AerospaceVillage/avBadge_2022/B2/images/usaf-b2-spirit-overhead-view.jpg

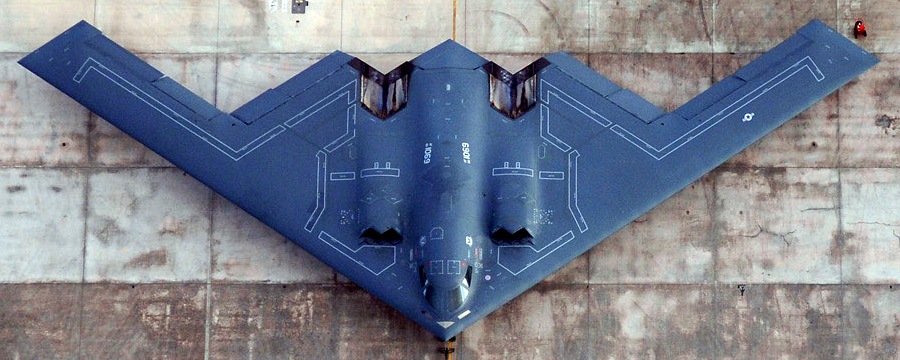
B2/images/usaf-b2-spirit-overhead-view.jpg
