AerospaceVillage/avBadge_2022/Images/DC30 theme.webp

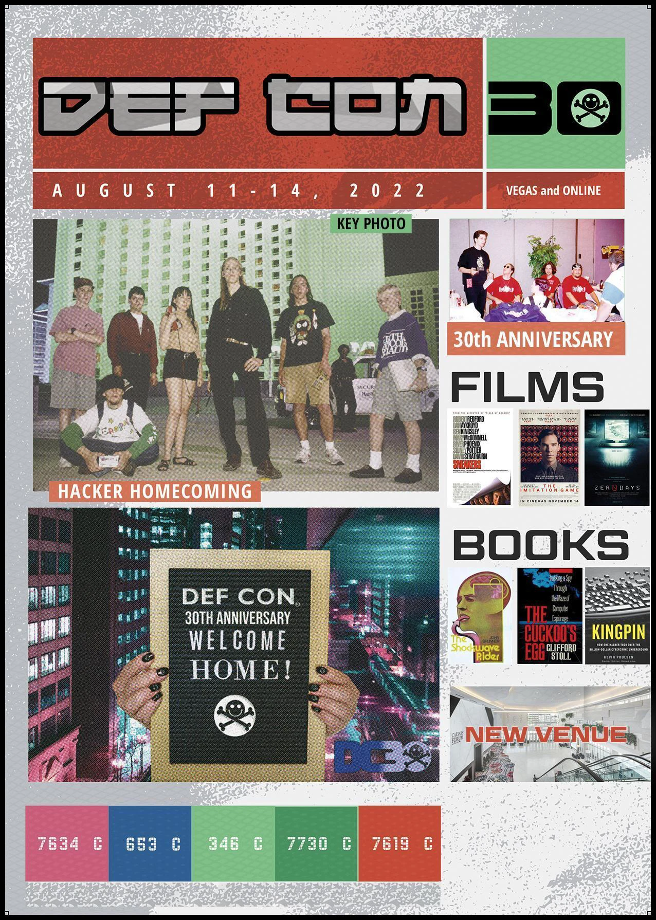
Images/DC30 theme.webp
