AerospaceVillage/avBadge_2022/README.md

# Aerospace Village Badge(s) for Defcon 2022

A collection of v1.69 SAO badges to be presented at DefCon 2022

4/25/2022
Began working in earnest on the primary base badge

5/11/2022
Surged today to get the Space and Earth portions into the JLCPCB manufacturer with SMT services for some of the components.
