AerospaceVillage/avBadge_2022/an225/images/An-124_and_An-225_top-view_silhouettes.png

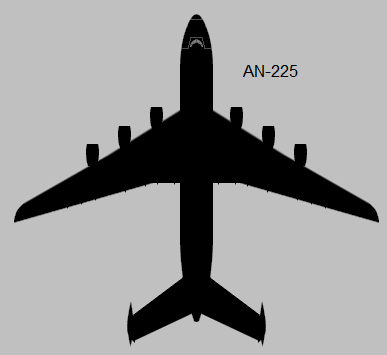
an225/images/An-124_and_An-225_top-view_silhouettes.png
