AerospaceVillage/avBadge_2022/B2/images/31hubGdG-TL._AC_.jpg

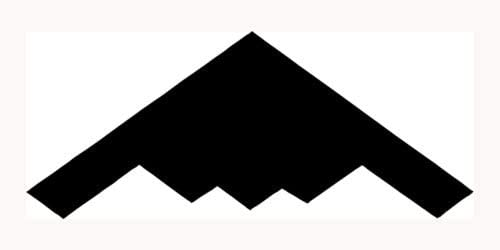
B2/images/31hubGdG-TL._AC_.jpg
