AerospaceVillage/avBadge_2022/B2/images/261D0600-A7CA-4D3E-8E26-1C9C6CC0517F.webp

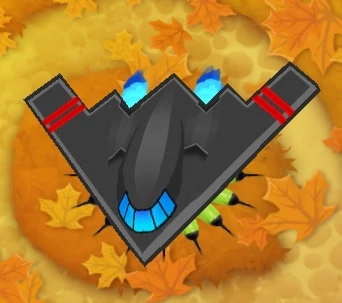
B2/images/261D0600-A7CA-4D3E-8E26-1C9C6CC0517F.webp
