AerospaceVillage/avBadge_2022/B2/images/1024px-B2_Spirit_closeup.JPEG

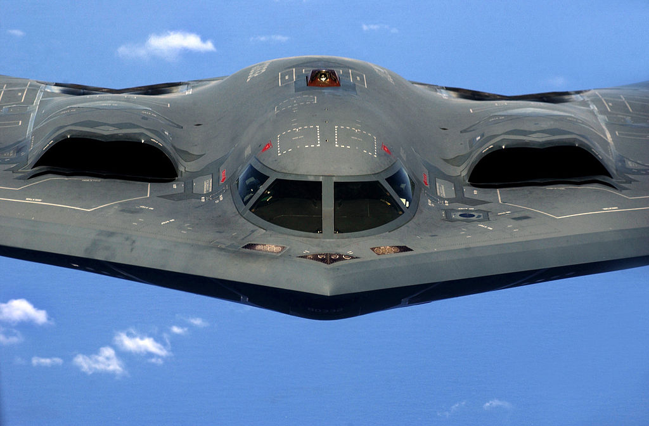
B2/images/1024px-B2_Spirit_closeup.JPEG
