AerospaceVillage/avBadge_2022/B2/images/b2-stealth-bomber-jet-aircraft-twilight-organic-synthesis.jpg

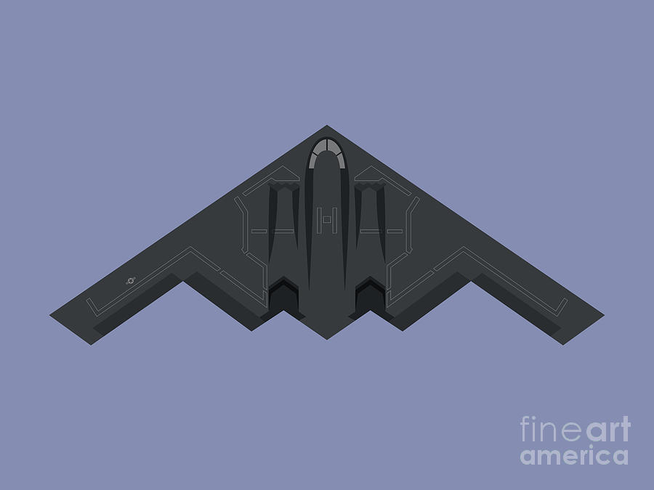
B2/images/b2-stealth-bomber-jet-aircraft-twilight-organic-synthesis.jpg
