AerospaceVillage/avBadge_2022/B2/images/b-2-tops-art.jpg

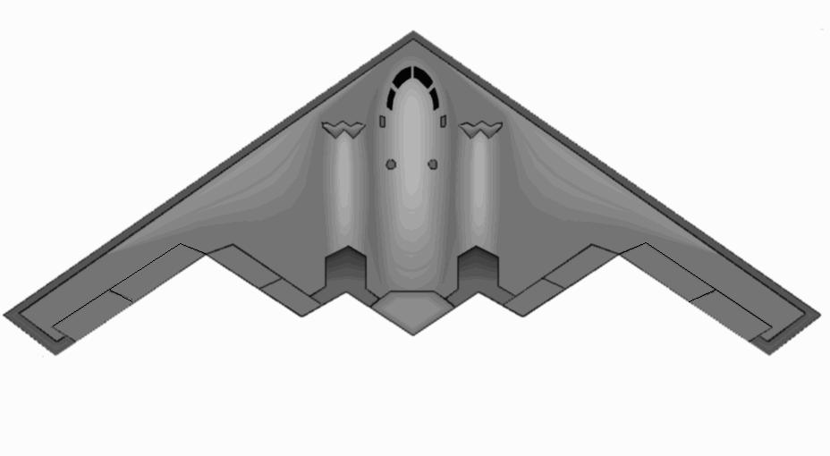
B2/images/b-2-tops-art.jpg
