AerospaceVillage/avBadge_2022/B2/images/b-2_line.gif

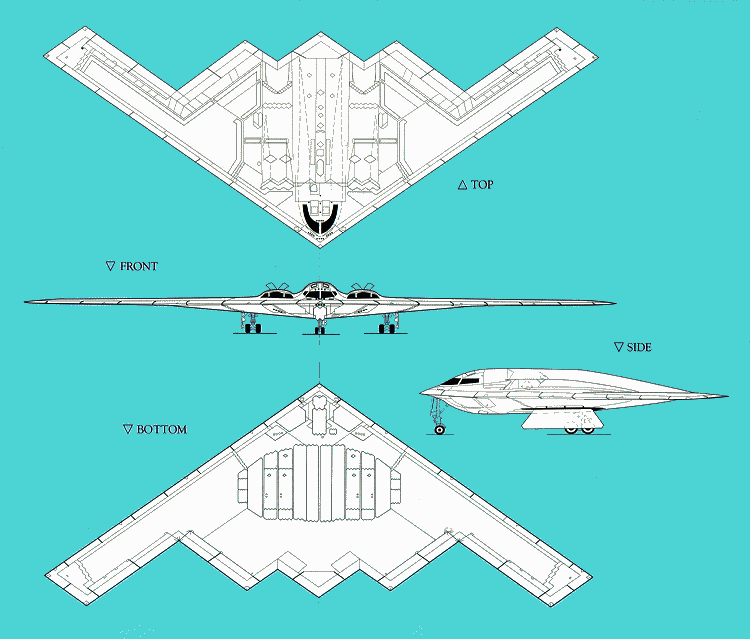
B2/images/b-2_line.gif
