AerospaceVillage/avBadge_2022/B2/images/B-2A_Silo500_ZE-300x300.png

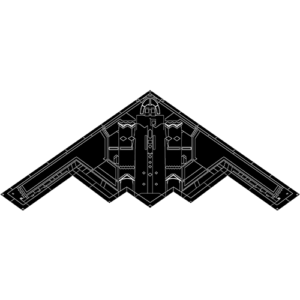
B2/images/B-2A_Silo500_ZE-300x300.png
