AerospaceVillage/avBadge_2022/B2/images/CleanShot 2022-07-21 at 14.04.40@2x.jpg

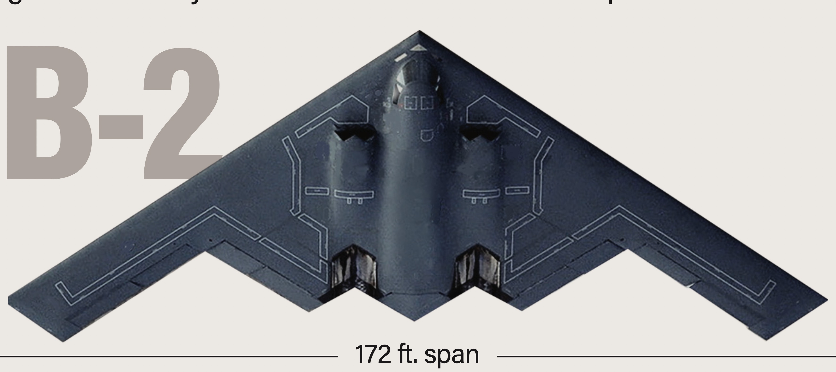
B2/images/CleanShot 2022-07-21 at 14.04.40@2x.jpg
