AerospaceVillage/avBadge_2022/Caution_SAO/Caution_SAO.png

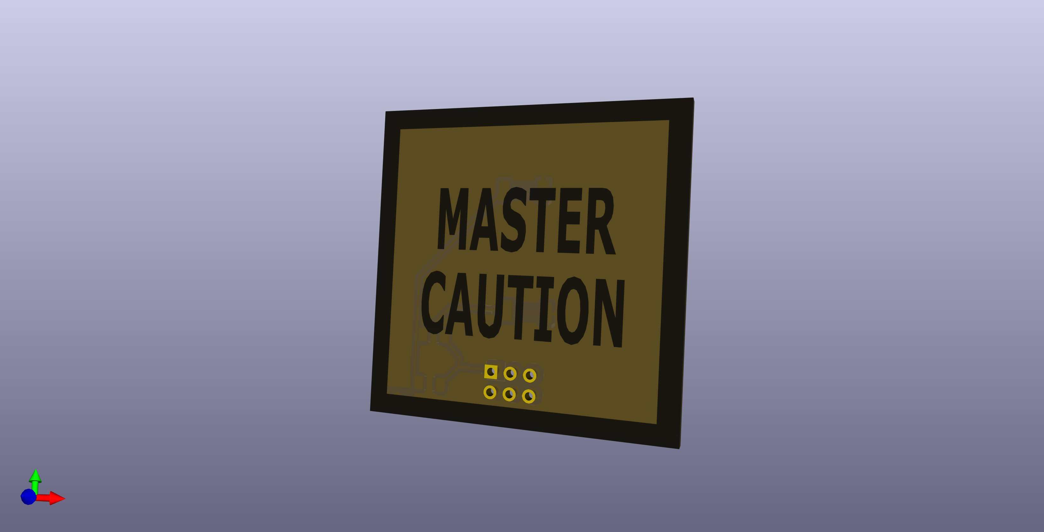
Caution_SAO/Caution_SAO.png
