AerospaceVillage/avBadge_2022/gold_star_v2_SAO/aerospace village - negative with filled background.png

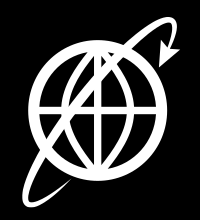
gold_star_v2_SAO/aerospace village - negative with filled background.png
