AerospaceVillage/avBadge_2022/gold_star_v2_SAO/aerospace village - no words.png

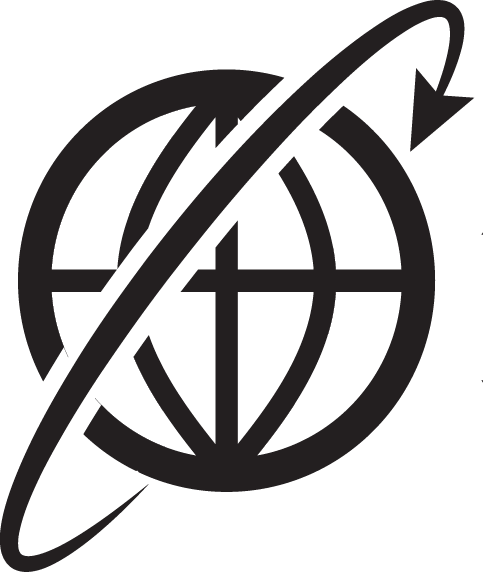
gold_star_v2_SAO/aerospace village - no words.png
