AerospaceVillage/avBadge_2022/james_webb_telescope_SAO/images/substrate mirror.png

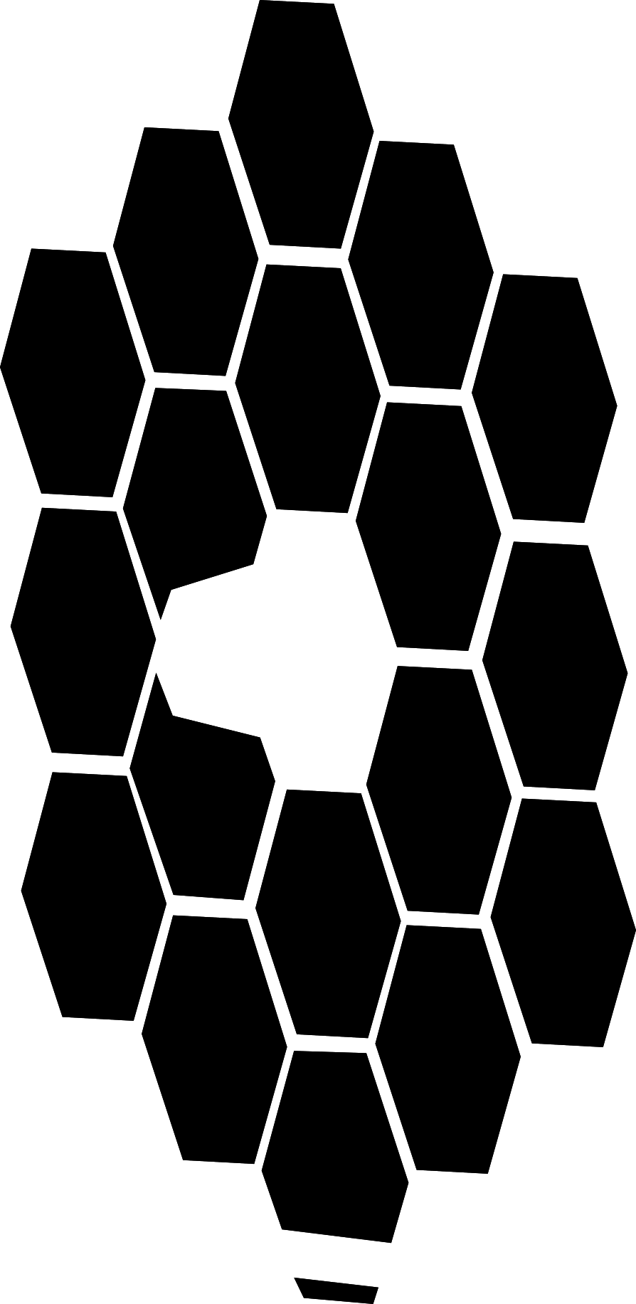
james_webb_telescope_SAO/images/substrate mirror.png
