AerospaceVillage/avBadge_2022/space_shuttle_SAO/space_shuttle_SAO.png

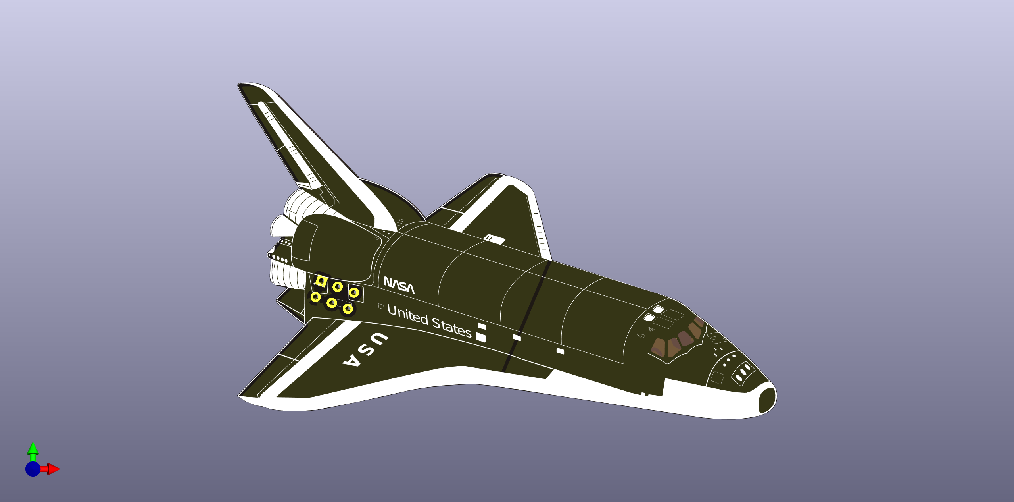
space_shuttle_SAO/space_shuttle_SAO.png
