AerospaceVillage/avBadge_2022/sr-71_SAO/sr-71.png

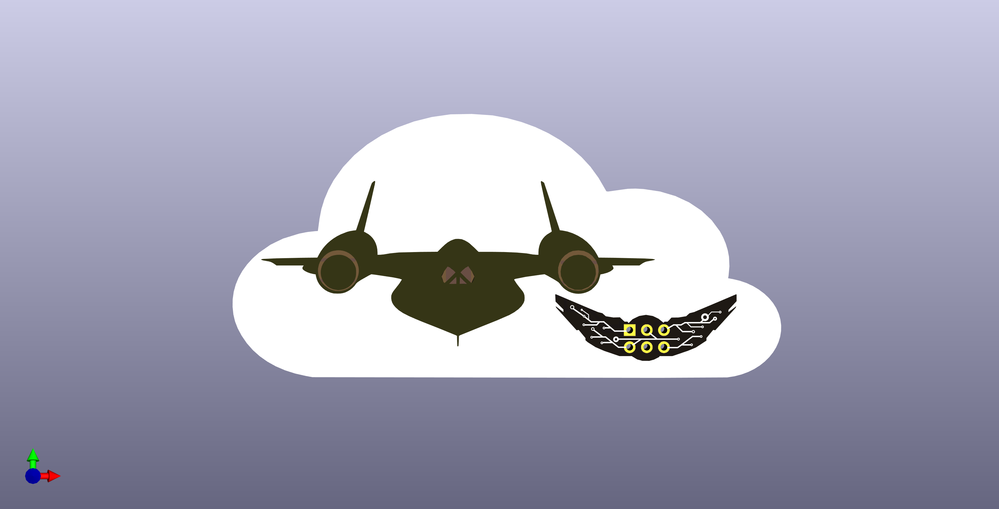
sr-71_SAO/sr-71.png
