AerospaceVillage/avBadge_2022/BaseBadge/earth_base/earth_base_BOM.csv

Comment | Designator | Footprint | LCSC Part Number
330 | R1, R2, R3, R4 | Capacitor_SMD:C_0805_2012Metric | C17630
LED | D1, D2, D3, D4 | 0603 | C72038
