AerospaceVillage/avBadge_2022/Images/sr71_symetricView.dxf

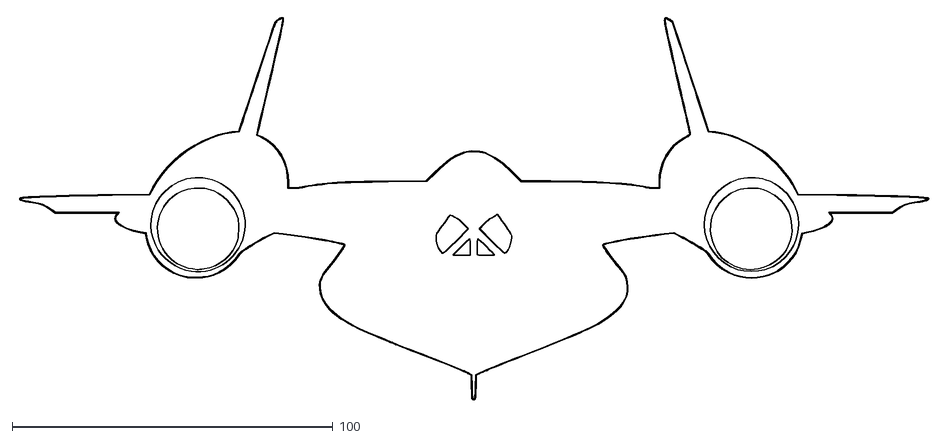
[picture p20: CAD file, 2022-04-05]
Images/sr71_symetricView.dxf
284.3 x 119.5
