AerospaceVillage/avBadge_2022/soldering jigs/sao_jig.stl

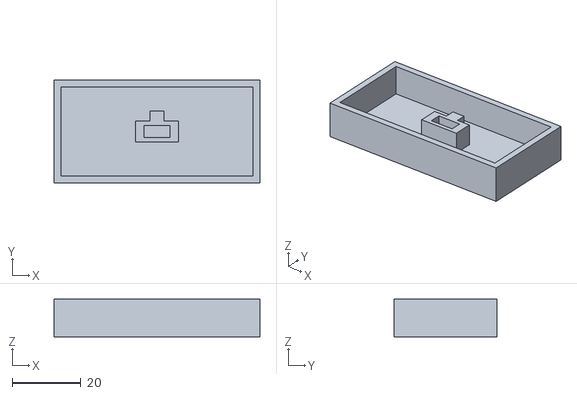
[picture p21: CAD file, 2022-07-29]
soldering jigs/sao_jig.stl
60.0 x 30.0 x 11.0
