AerospaceVillage/avBadge_2022/Images/aerospace_logo_new.dxf

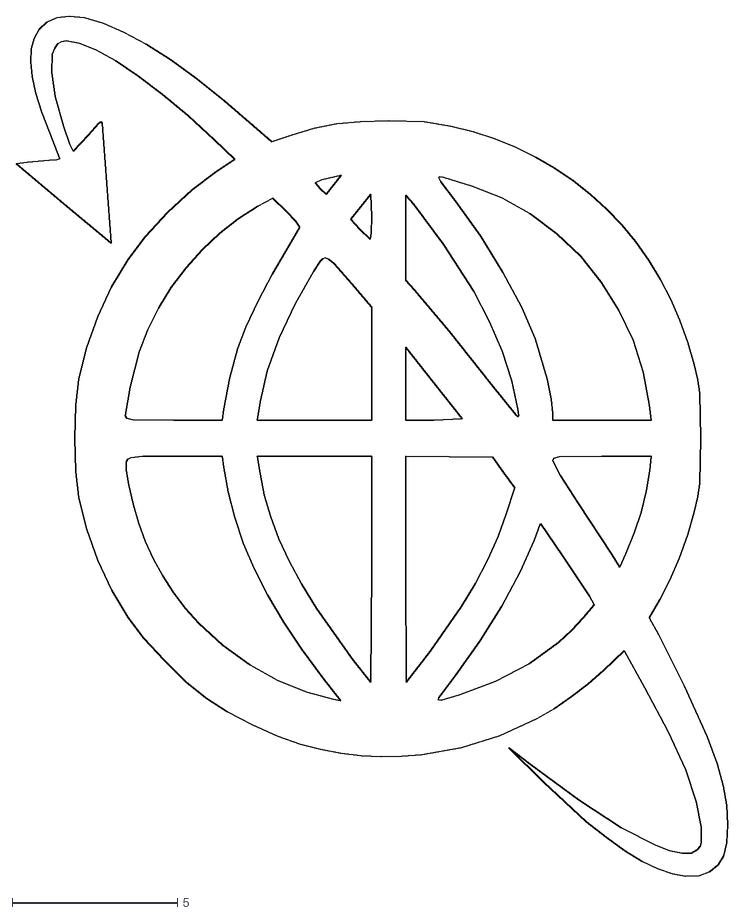
[picture p22: CAD file, 2022-04-05]
Images/aerospace_logo_new.dxf
21.5 x 26.0
