AerospaceVillage/avBadge_2022/soldering jigs/sao_jig-x15.3mf

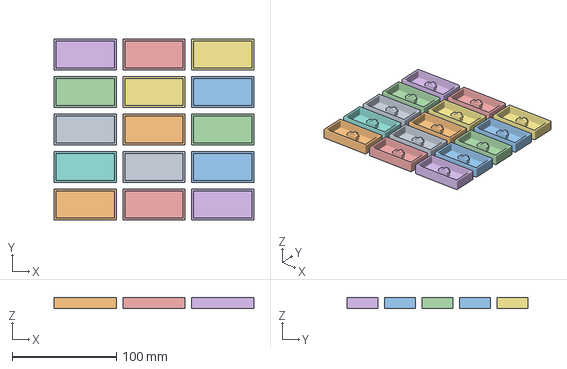
[picture p23: CAD file, 2022-07-29]
soldering jigs/sao_jig-x15.3mf
192.0 x 174.0 x 11.0 mm
