AerospaceVillage/avBadge_2022/Images/sr71_symetricView_outline.dxf

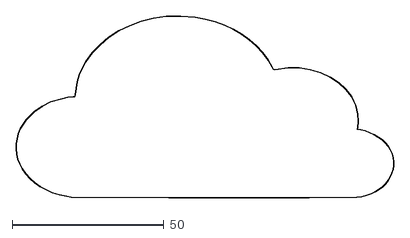
[picture p24: CAD file, 2022-04-05]
Images/sr71_symetricView_outline.dxf
124.3 x 59.8
