AerospaceVillage/avBadge_2022/(list of files, cad)

Other CAD files:
soldering jigs/sao_jig-single.3mf
