AerospaceVillage/avBadge_2022/space_shuttle_SAO/assembly instructions/shuttle_SAO_assembly.pdf

# Aerospace Village Badge 2022 Shuttle SAO Assembly

Components:
- SAO Male Connector
- x1 330 Ohm reistors
- x1 Yellow LEDs

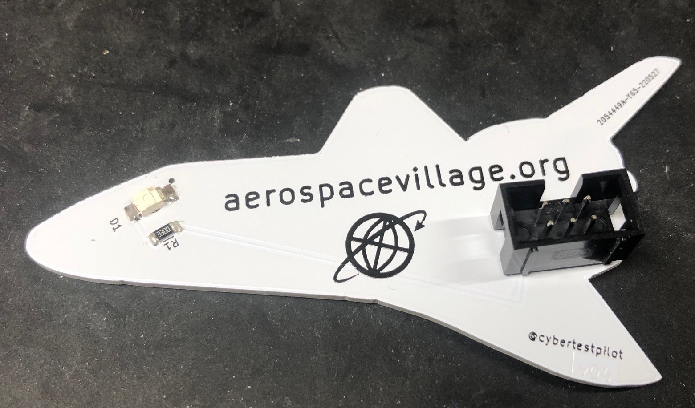
[picture p25: figure]

1. Solder the resistor to the respective pads. Note: Orientation does not matter for the resistor.
2. Orient the yellow LED so that the circles on the PCB and LED are adjacent to one another and then solder the LEDs in place.

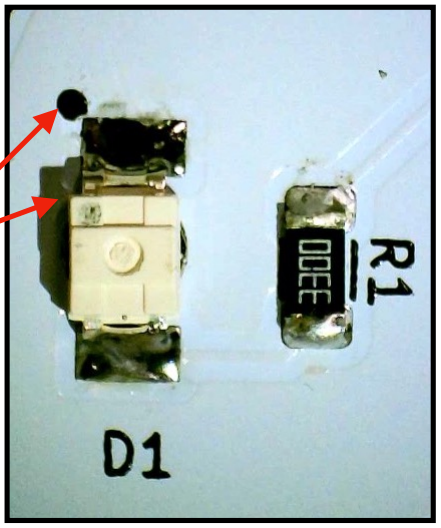
[picture p26: figure]
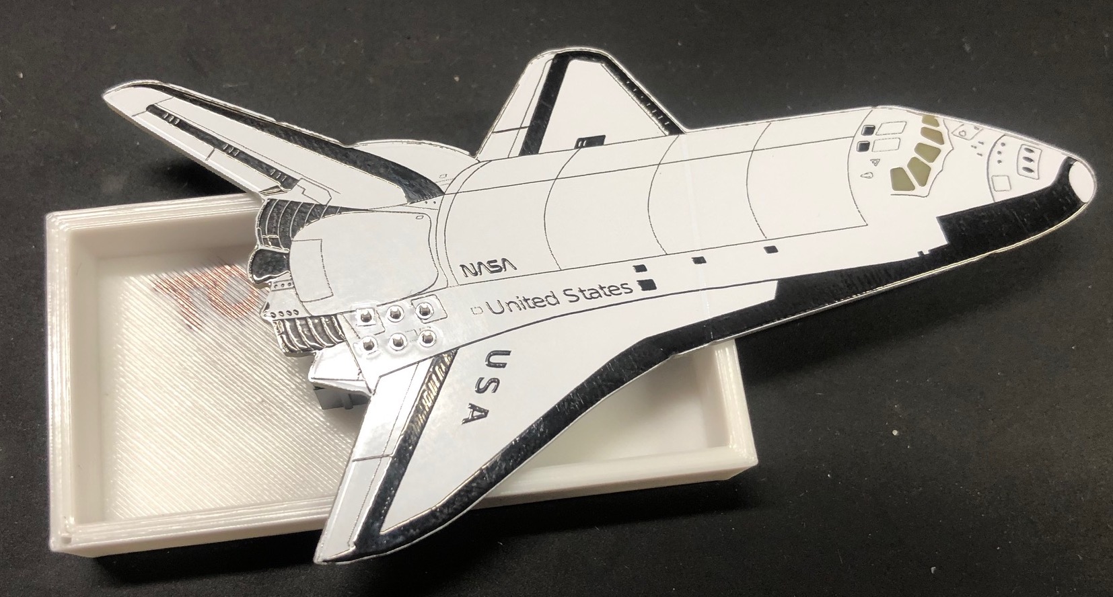
[picture p27: figure]

3. Using the SAO jig solder the connector to the back of the PCB.
4. Ensure correct operation.

Observe the
orientation markings

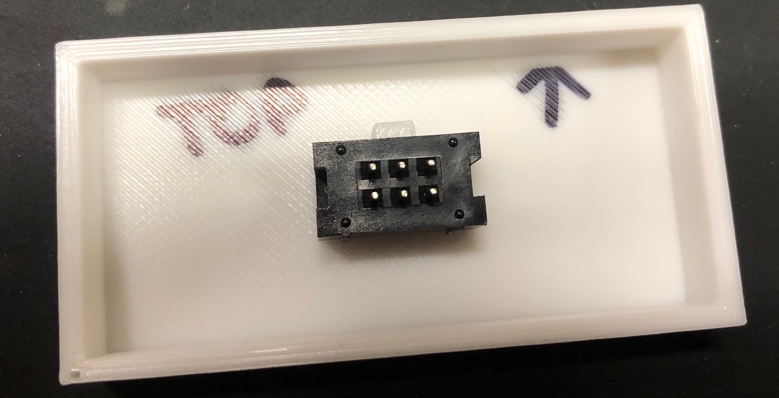
[picture p28: figure]
