AerospaceVillage/avBadge_2022/Warning_SAO/assembly instructions/warning_SAO_assembly.pdf

# Aerospace Village Badge 2022 Warning SAO Assembly

Components:
- SAO Male Connector
- x2 1K Ohm reistors
- x2 Red LEDs

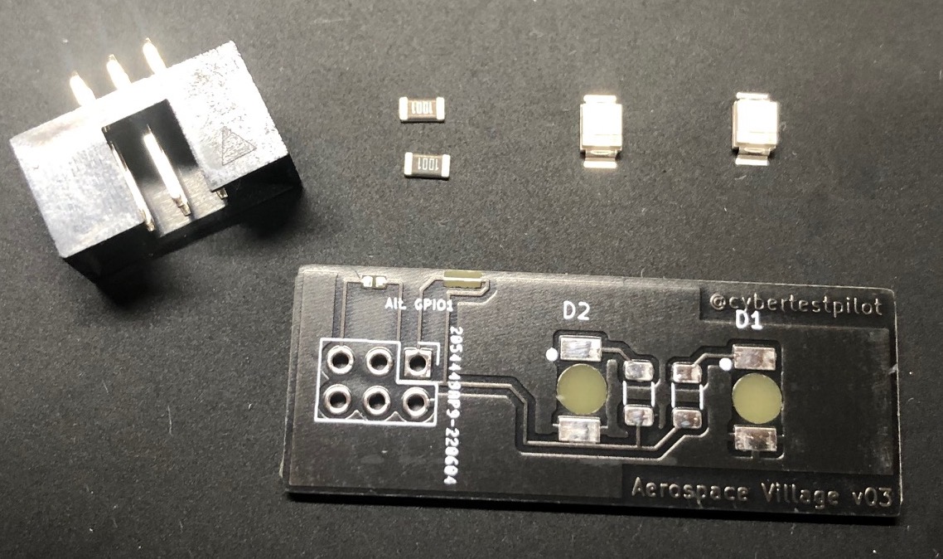
[picture p29: figure]

1. Solder the resistors to their respective pads. Note: Orientation does not matter for the resistors
2. Orient the red LEDs so that the circles on the PCB and LED are adjacent to one another and then solder the LEDs in place.

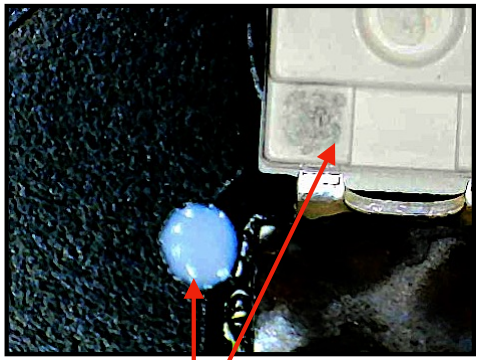
[picture p30: figure]
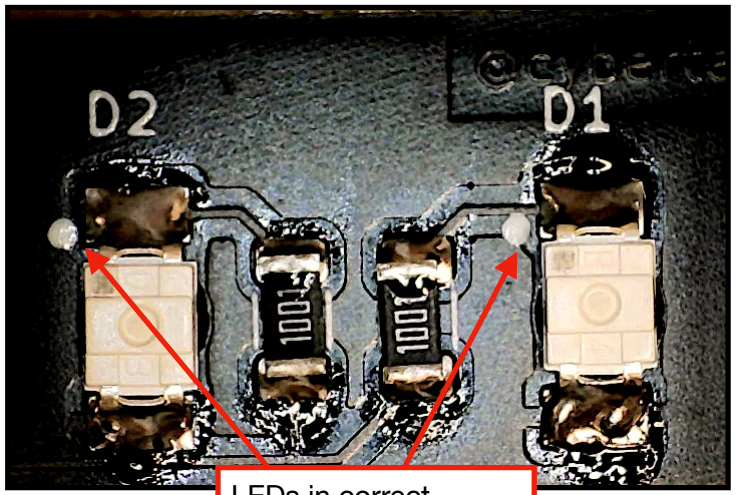
[picture p31: figure]

3. Using the SAO jig solder the connector to the back of the PCB.


4. Ensure correct operation.

LEDs in correct
orientation

Observe the
orientation markings

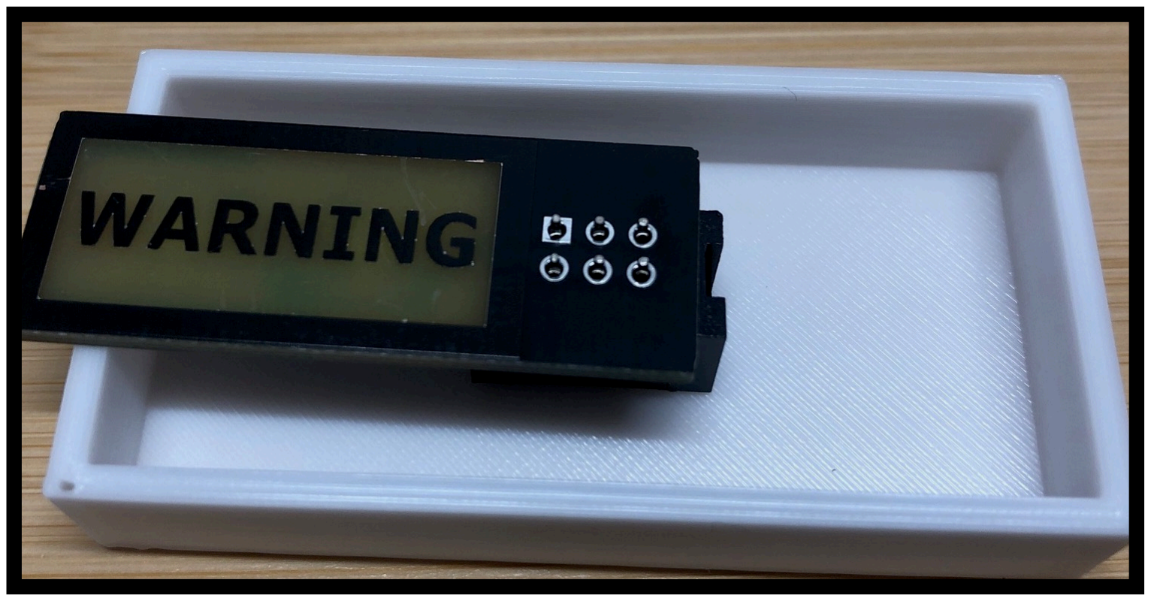
[picture p32: figure]
