AerospaceVillage/avBadge_2022/787 SAO multiplier/787.kicad_pcb

## KiCad design 787 SAO multiplier/787.kicad_pcb (2022-07-29)

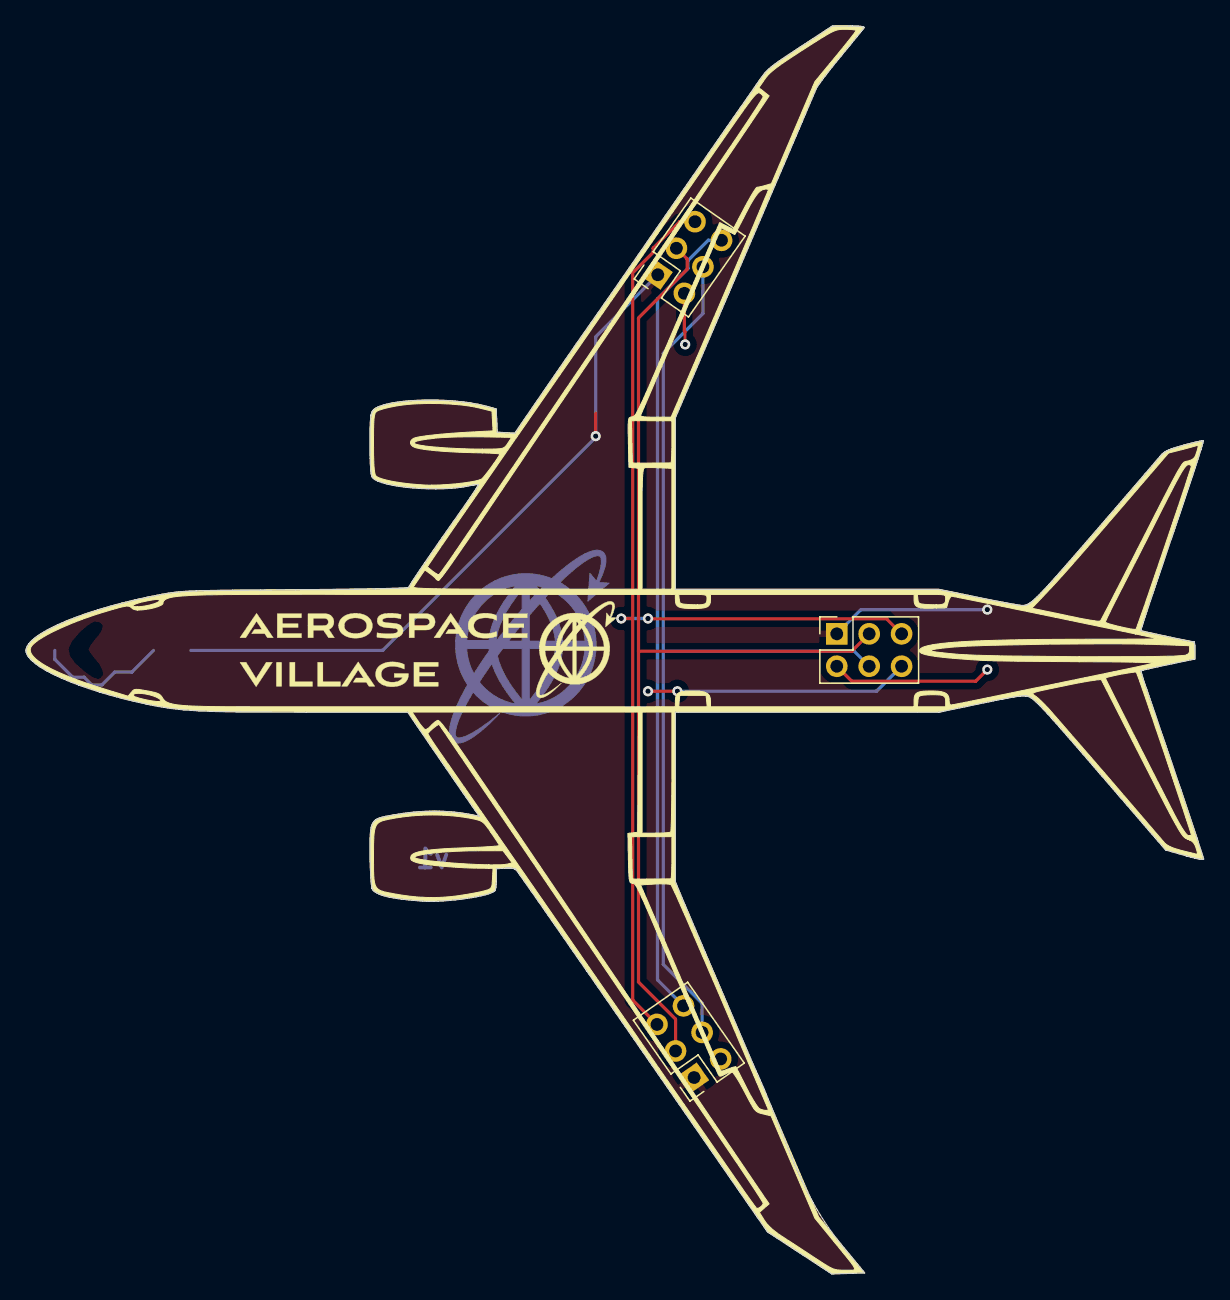
[picture p35: board 787.kicad_pcb from above]

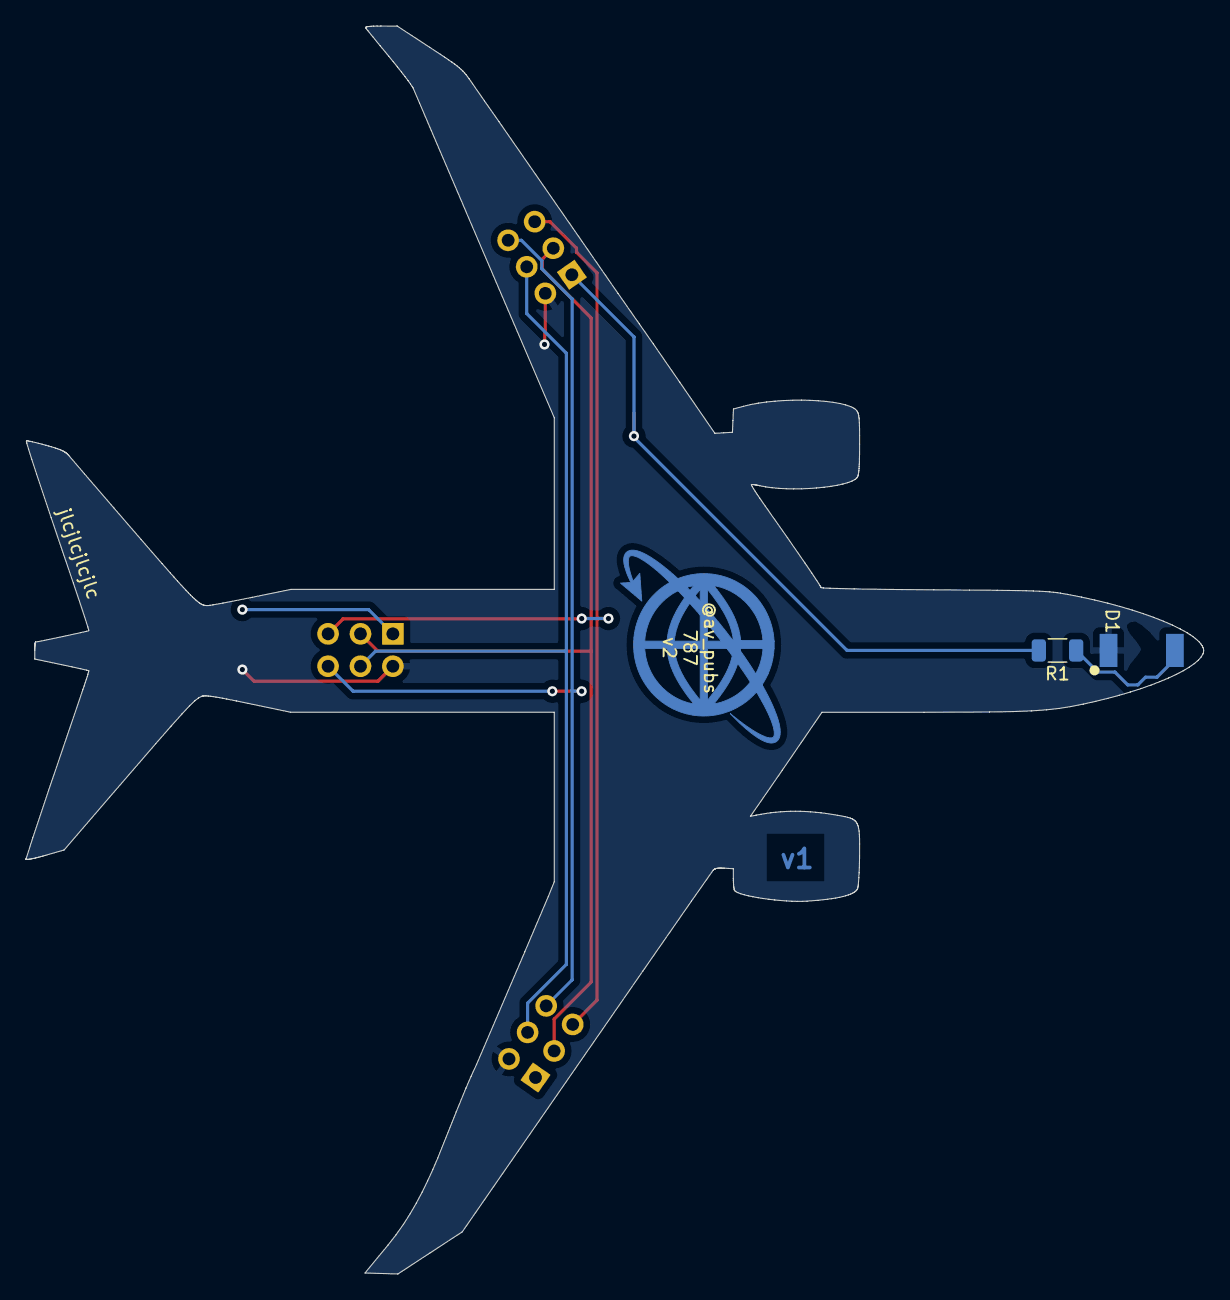
[picture p36: board 787.kicad_pcb from below]

Board: 2 copper layers, 92.3 x 97.8 mm, 5 parts (2 on the bottom side), 7 nets.

Parts:
D1: LED; XZMYK45WT-9
J1, J2, J3: Conn_02x03_Counter_Clockwise; PinSocket_2x03_P2.54mm_Vertical
R1: R; R_1206_3216Metric

Connections:
+3V3: J1.1, J2.1, J3.1, R1.2
GND: D1.1 (K), J1.2, J2.2, J3.2
unnamed: D1.2 (A), R1.1
unnamed: J1.3, J2.3, J3.3
unnamed: J1.4, J2.4, J3.4
unnamed: J1.5, J2.5, J3.5
unnamed: J1.6, J2.6, J3.6
