AerospaceVillage/avBadge_2022/VORTAC_SAO/VORTAC SAO Board.kicad_pcb

## KiCad design VORTAC_SAO/VORTAC SAO Board.kicad_pcb (2022-07-29)

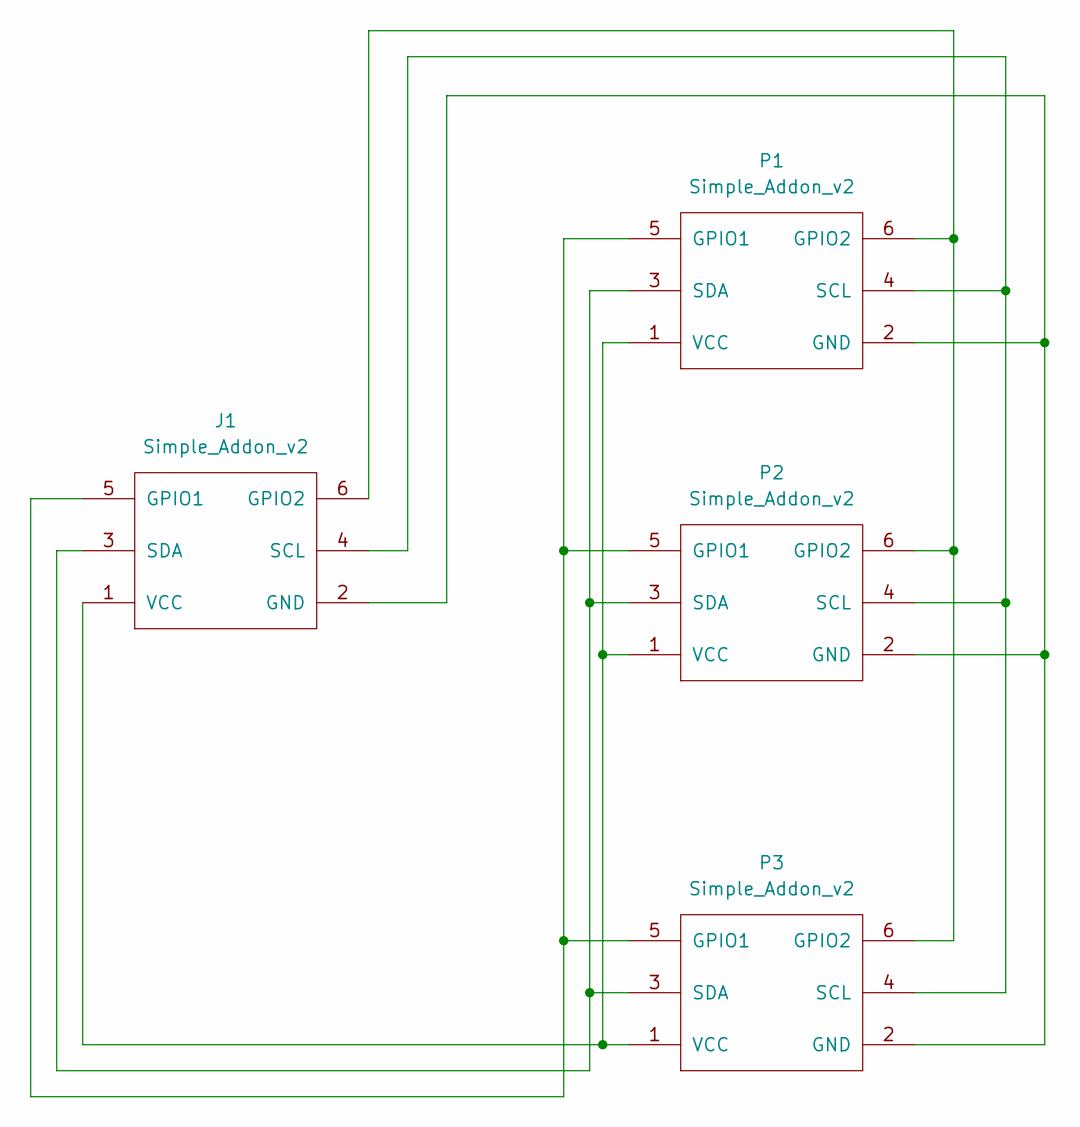
[picture p37: schematic VORTAC SAO Board.kicad_sch]

Parts:
J1: Simple_Addon_v2; Simple_Addon_v2-SAO-2x3
P1, P2, P3: Simple_Addon_v2; Simple_Addon_v2-BADGE-2x3

Connections:
unnamed: J1.1 (VCC), P1.1 (VCC), P2.1 (VCC), P3.1 (VCC)
unnamed: J1.2 (GND), P1.2 (GND), P2.2 (GND), P3.2 (GND)
unnamed: J1.3 (SDA), P1.3 (SDA), P2.3 (SDA), P3.3 (SDA)
unnamed: J1.4 (SCL), P1.4 (SCL), P2.4 (SCL), P3.4 (SCL)
unnamed: J1.5 (GPIO1), P1.5 (GPIO1), P2.5 (GPIO1), P3.5 (GPIO1)
unnamed: J1.6 (GPIO2), P1.6 (GPIO2), P2.6 (GPIO2), P3.6 (GPIO2)

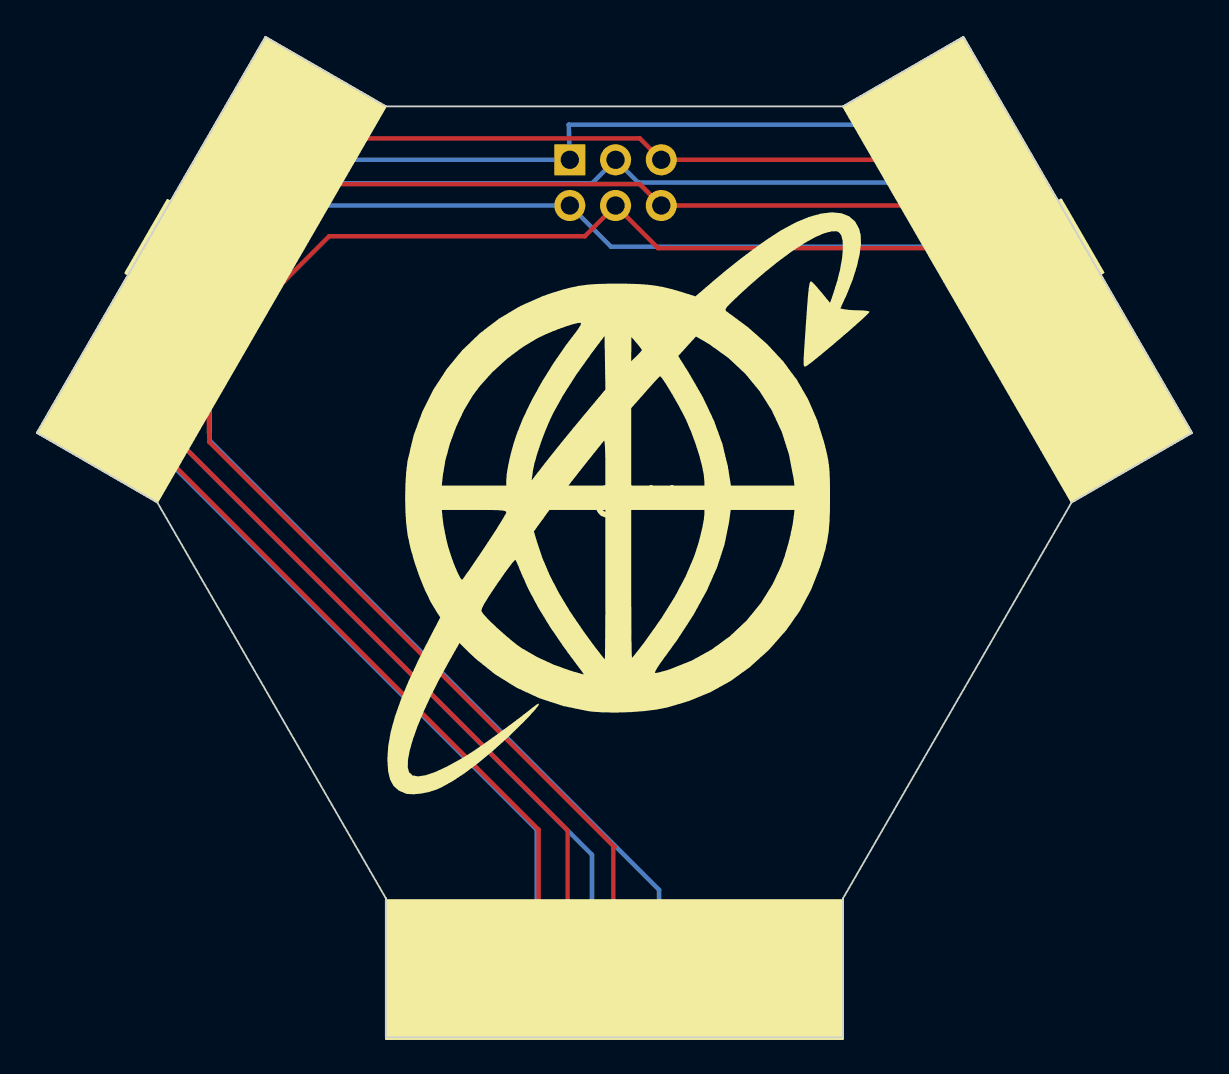
[picture p38: board VORTAC SAO Board.kicad_pcb from above]

Board: 2 copper layers, 64.2 x 55.6 mm, 4 parts (0 on the bottom side), 6 nets.
