AerospaceVillage/avBadge_2022/BaseBadge/space_base/BaseBadge.kicad_pcb

## KiCad design BaseBadge/space_base/BaseBadge.kicad_pcb (2022-06-02)

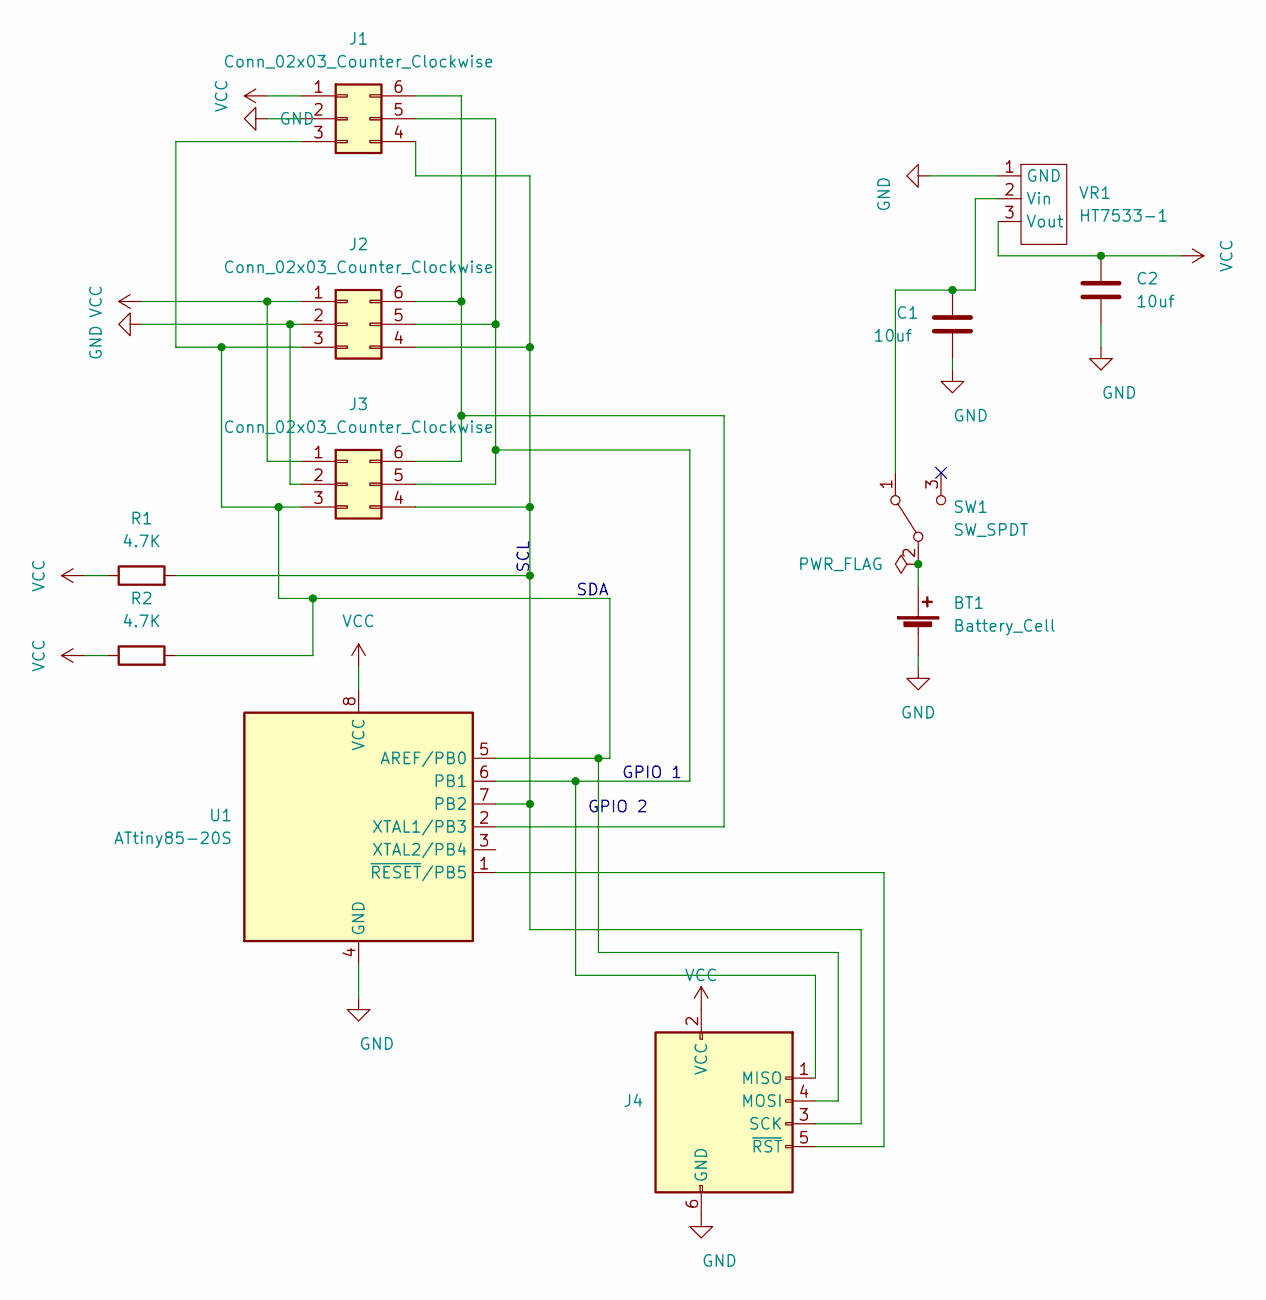
[picture p40: schematic BaseBadge.kicad_sch]

Parts:
BT1: Battery_Cell; 2479
C1, C2: 10uf; C_0805_2012Metric
J1: Conn_02x03_Counter_Clockwise; space2sky_connector
J2, J3: Conn_02x03_Counter_Clockwise; PinSocket_2x03_P2.54mm_Vertical
J4: (no value)
R1, R2: 4.7K; R_0805_2012Metric
SW1: SW_SPDT; switch_JS202011SCQN
U1: ATtiny85-20S; SOIC-8W_5.3x5.3mm_P1.27mm
VR1: HT7533-1; SOT-89-3

Connections:
GND: BT1.2 (-), C1.2, C2.2, J1.2, J2.2, J3.2, J4.6 (GND), U1.4 (GND), VR1.1 (GND)
unnamed: BT1.1 (+), SW1.2 (B)
unnamed: C1.1, SW1.1 (A), VR1.2 (Vin)
unnamed: J1.3, J2.3, J3.3, J4.4 (MOSI), R2.2, U1.5 (AREF/PB0)
unnamed: J1.4, J2.4, J3.4, J4.3 (SCK), R1.2, U1.7 (PB2)
unnamed: J1.5, J2.5, J3.5, J4.1 (MISO), U1.6 (PB1)
unnamed: J1.6, J2.6, J3.6, U1.2 (XTAL1/PB3)
unnamed: J4.5 (~RST), U1.1 (~RESET/PB5)
VCC: C2.1, J1.1, J2.1, J3.1, J4.2 (VCC), R1.1, R2.1, U1.8 (VCC), VR1.3 (Vout)

Notes on the sheet:
GPIO 2
SDA
SCL
GPIO 1

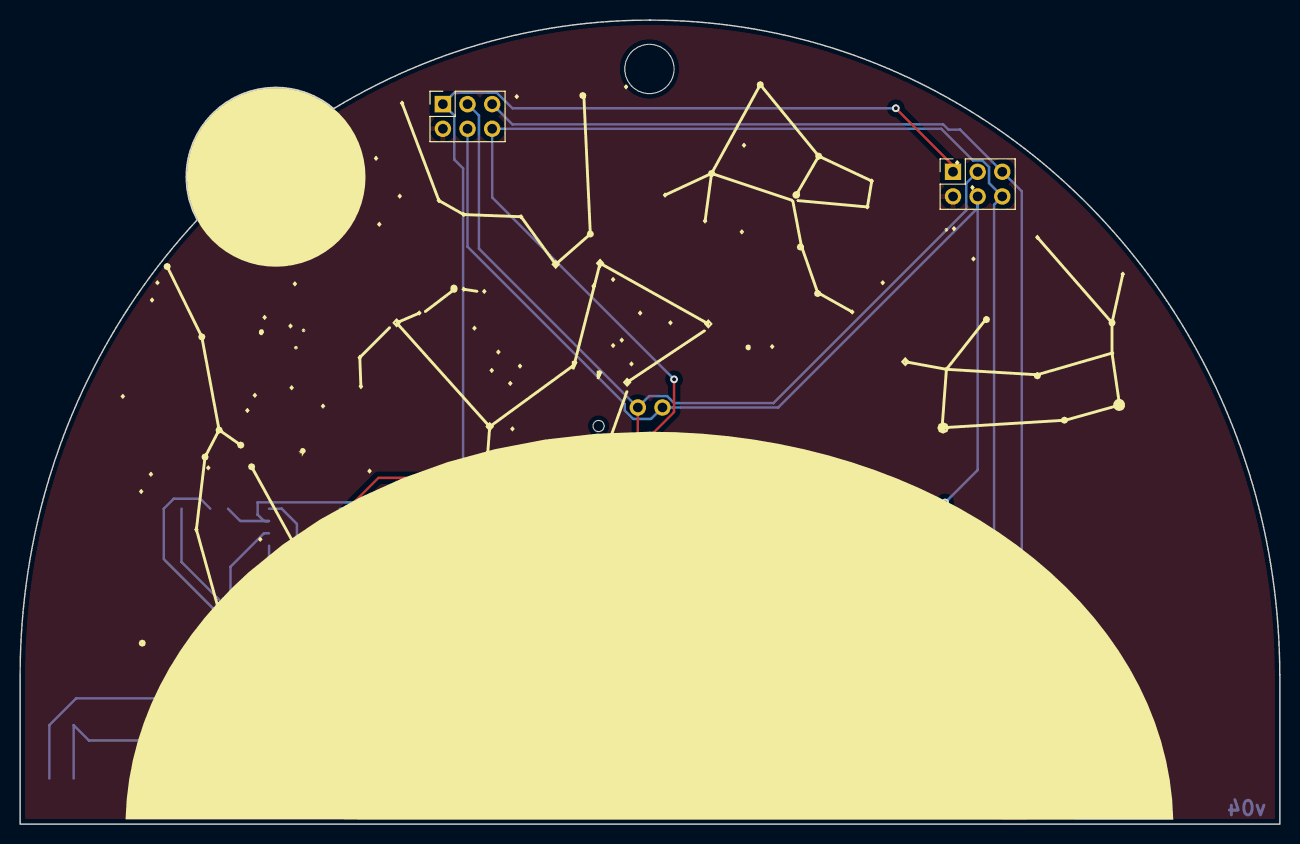
[picture p41: board BaseBadge.kicad_pcb from above]

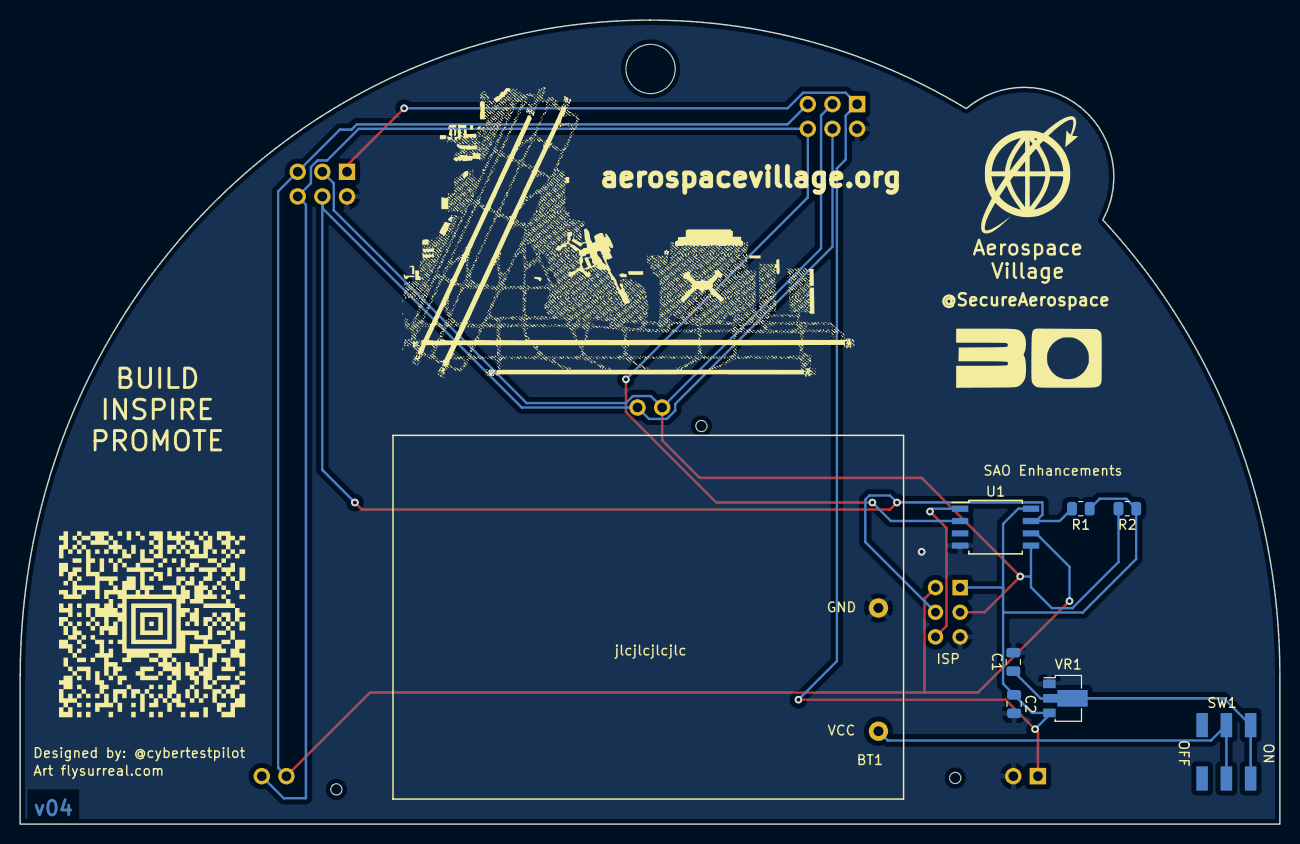
[picture p42: board BaseBadge.kicad_pcb from below]

Board: 2 copper layers, 129.9 x 82.9 mm, 15 parts (11 on the bottom side), 9 nets.

Other parts of the board:
svg2mod: G***; space_base
svg2mod#2: G***; defcon_30_logo
svg2mod#3: G***; aerospace_logo_new
