AerospaceVillage/avBadge_2022/space_shuttle_SAO/space_shuttle_SAO.kicad_pcb

## KiCad design space_shuttle_SAO/space_shuttle_SAO.kicad_pcb (2022-05-26)

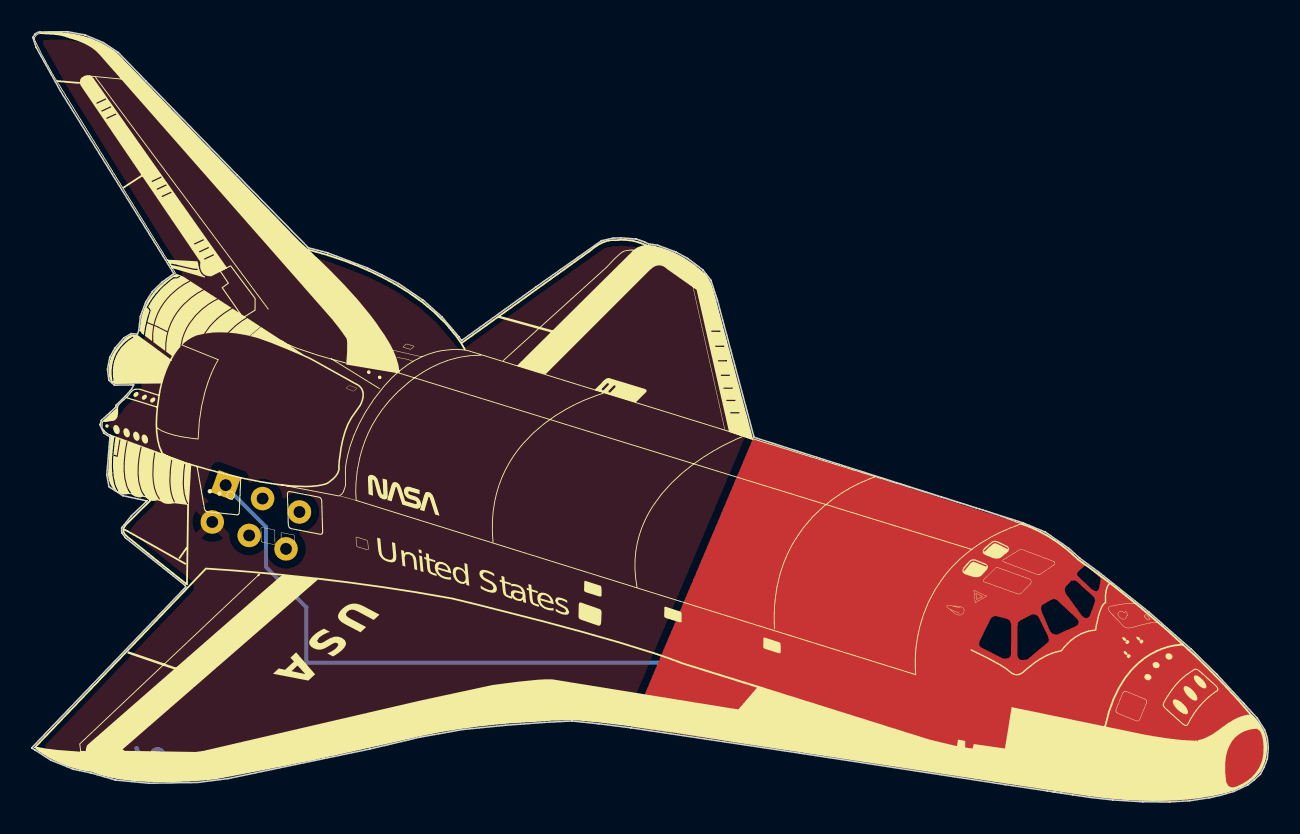
[picture p43: board space_shuttle_SAO.kicad_pcb from above]

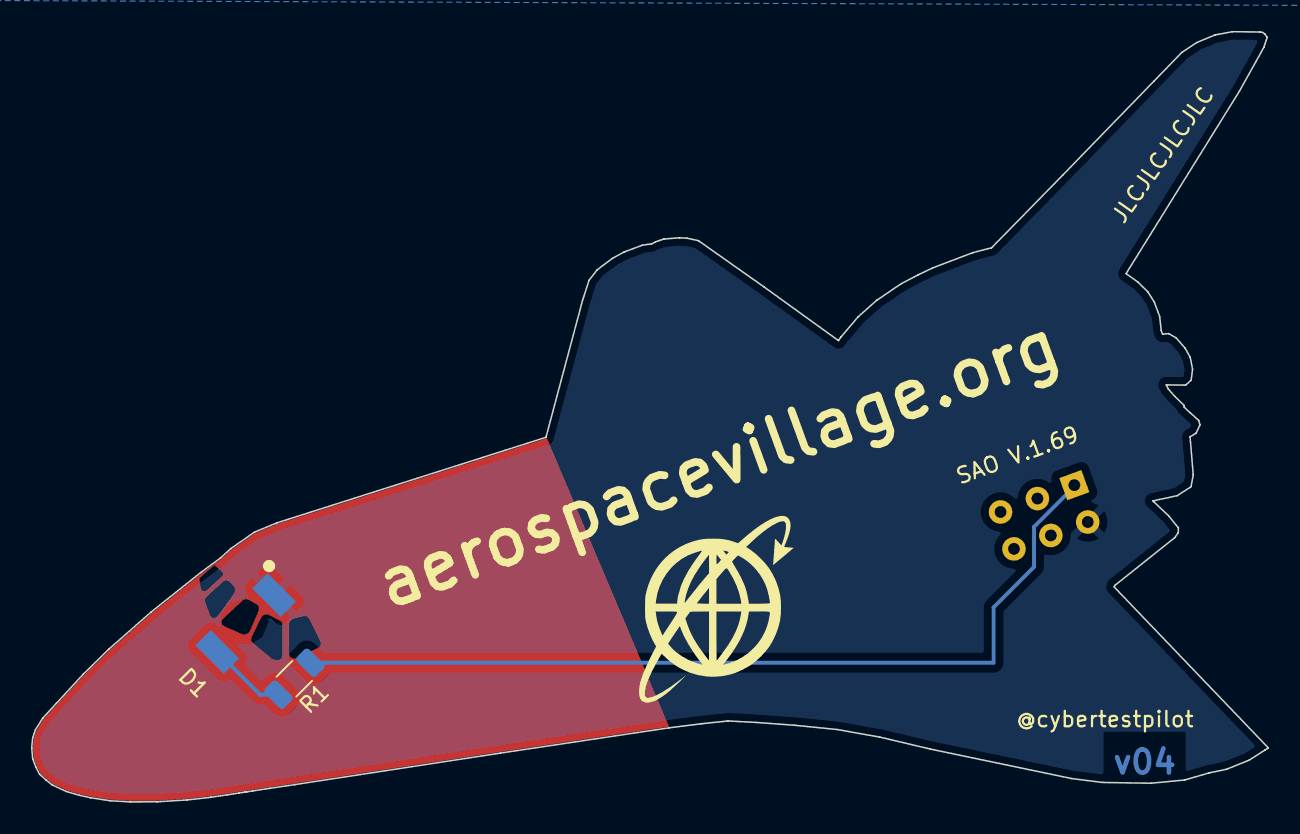
[picture p44: board space_shuttle_SAO.kicad_pcb from below]

Board: 2 copper layers, 80.0 x 49.8 mm, 5 parts (3 on the bottom side), 3 nets.

Parts:
D1: LED; XZMYK45WT-9
J1: SAO_1.69; sao_1.69
R1: 330; R_1206_3216Metric
svg2mod: G***; space_shuttle_proper
svg2mod#2: G***; aerospace_logo_new

Connections:
GND: D1.1 (K), J1.2 (GND)
unnamed: D1.2 (A), R1.2
unnamed: J1.1 (VCC), R1.1
