AerospaceVillage/avBadge_2022/BaseBadge/earth_base/earth_base.kicad_pcb

## KiCad design BaseBadge/earth_base/earth_base.kicad_pcb (2022-05-22)

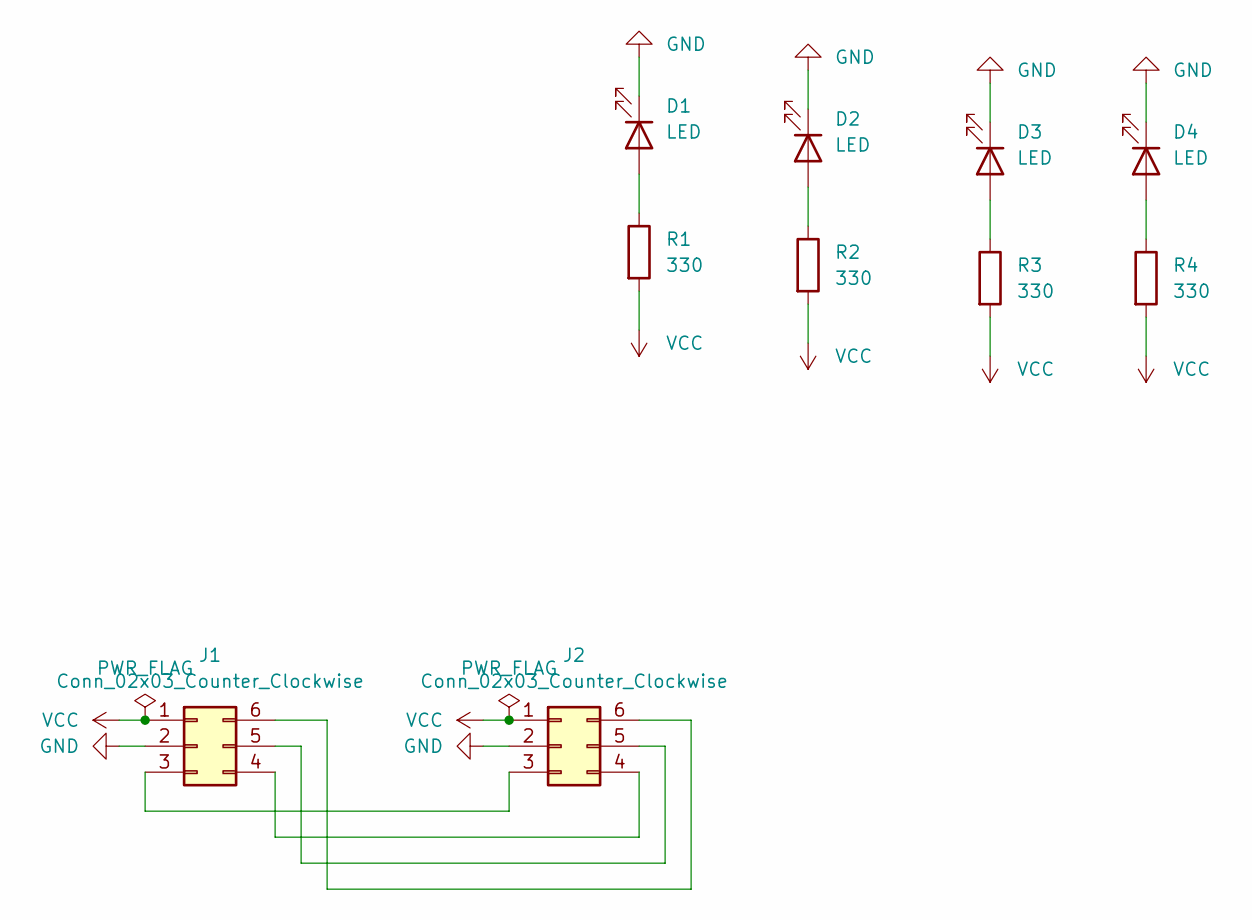
[picture p45: schematic earth_base.kicad_sch]

Parts:
D1, D2, D3, D4: LED
J1: Conn_02x03_Counter_Clockwise; sky2ground_connector
J2: Conn_02x03_Counter_Clockwise; PinSocket_2x03_P2.54mm_Vertical
R1, R2, R3, R4: 330; R_0805_2012Metric

Connections:
GND: D1.1 (K), D2.1 (K), D3.1 (K), D4.1 (K), J1.2, J2.2
unnamed: D1.2 (A), R1.1
unnamed: D2.2 (A), R2.1
unnamed: D3.2 (A), R3.1
unnamed: D4.2 (A), R4.1
unnamed: J1.3, J2.3
unnamed: J1.4, J2.4
unnamed: J1.5, J2.5
unnamed: J1.6, J2.6
VCC: J1.1, J2.1, R1.2, R2.2, R3.2, R4.2

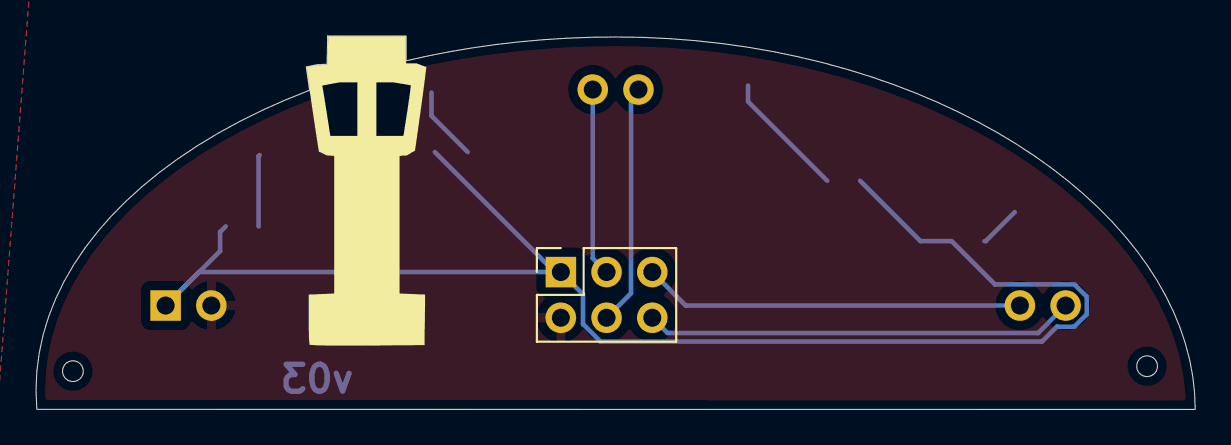
[picture p46: board earth_base.kicad_pcb from above]

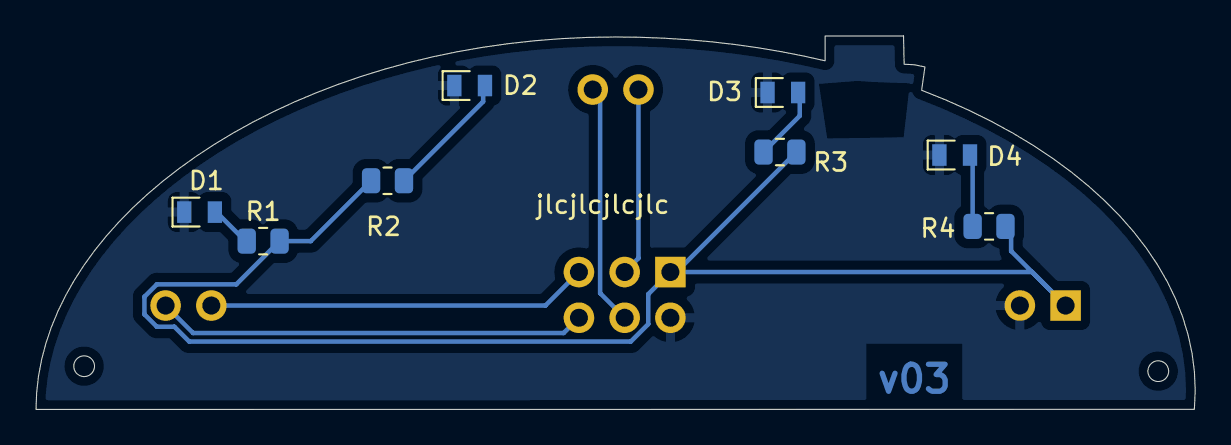
[picture p47: board earth_base.kicad_pcb from below]

Board: 2 copper layers, 64.4 x 20.7 mm, 11 parts (8 on the bottom side), 10 nets.

Other parts of the board:
svg2mod: G***; earth_base
