AerospaceVillage/avBadge_2022/BaseBadge/sky_base/sky_base.kicad_pcb

## KiCad design BaseBadge/sky_base/sky_base.kicad_pcb (2022-05-11)

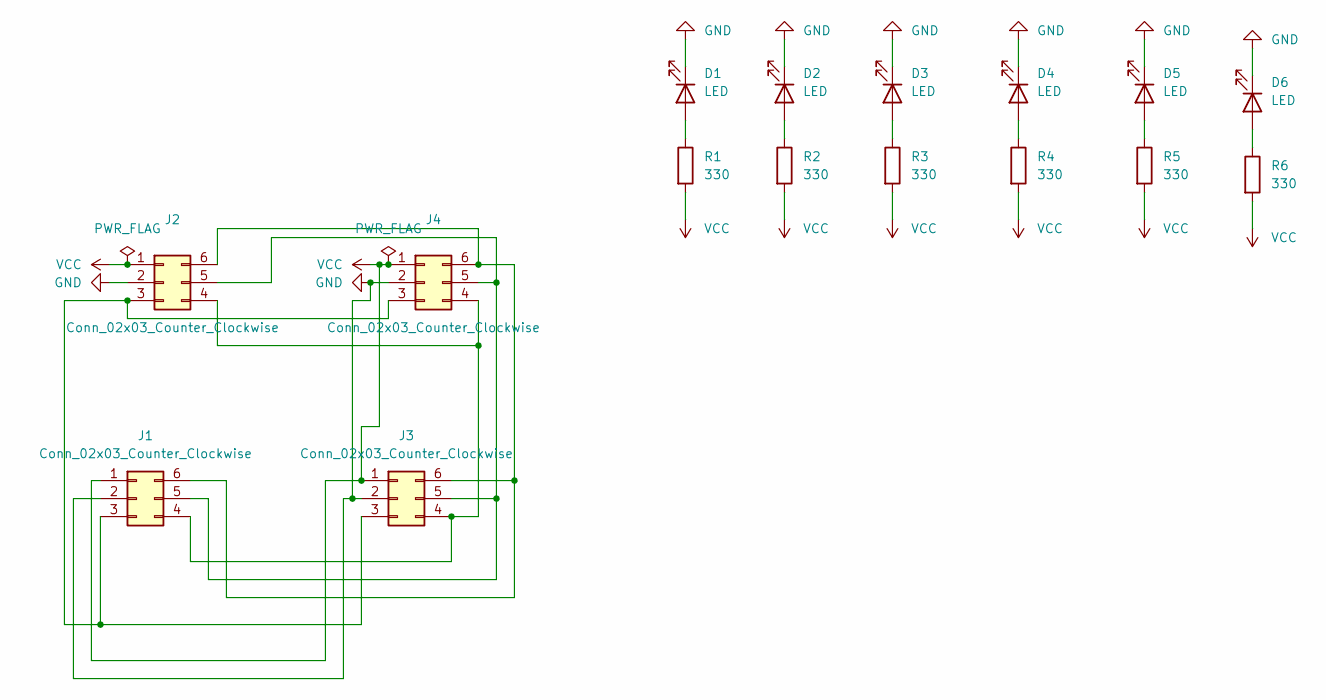
[picture p48: schematic sky_base.kicad_sch]

Parts:
D1, D2, D3, D4, D5, D6: LED; APTR3216-VFX
J1, J3: Conn_02x03_Counter_Clockwise; PinHeader_2x03_P2.54mm_Vertical
J2: Conn_02x03_Counter_Clockwise; space2sky_connector
J4: Conn_02x03_Counter_Clockwise; sky2ground_connector
R1, R2, R3, R4, R5, R6: 330; R_1206_3216Metric_Pad1.30x1.75mm_HandSolder

Connections:
GND: D1.1 (K), D2.1 (K), D3.1 (K), D4.1 (K), D5.1 (K), D6.1 (K), J1.2, J2.2, J3.2, J4.2
unnamed: D1.2 (A), R1.1
unnamed: D2.2 (A), R2.1
unnamed: D3.2 (A), R3.1
unnamed: D4.2 (A), R4.1
unnamed: D5.2 (A), R5.1
unnamed: D6.2 (A), R6.1
unnamed: J1.4, J2.4, J3.4, J4.4
unnamed: J1.5, J2.5, J3.5, J4.5
unnamed: J1.6, J2.6, J3.6, J4.6
unnamed: J1.3, J2.3, J3.3, J4.3
VCC: J1.1, J2.1, J3.1, J4.1, R1.2, R2.2, R3.2, R4.2, R5.2, R6.2

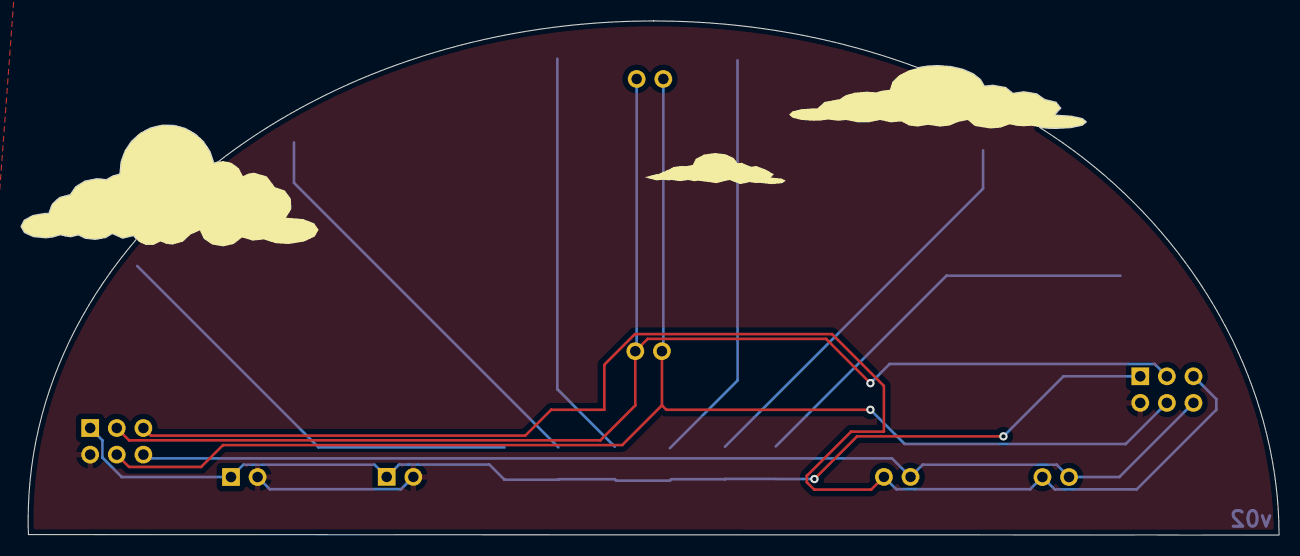
[picture p49: board sky_base.kicad_pcb from above]

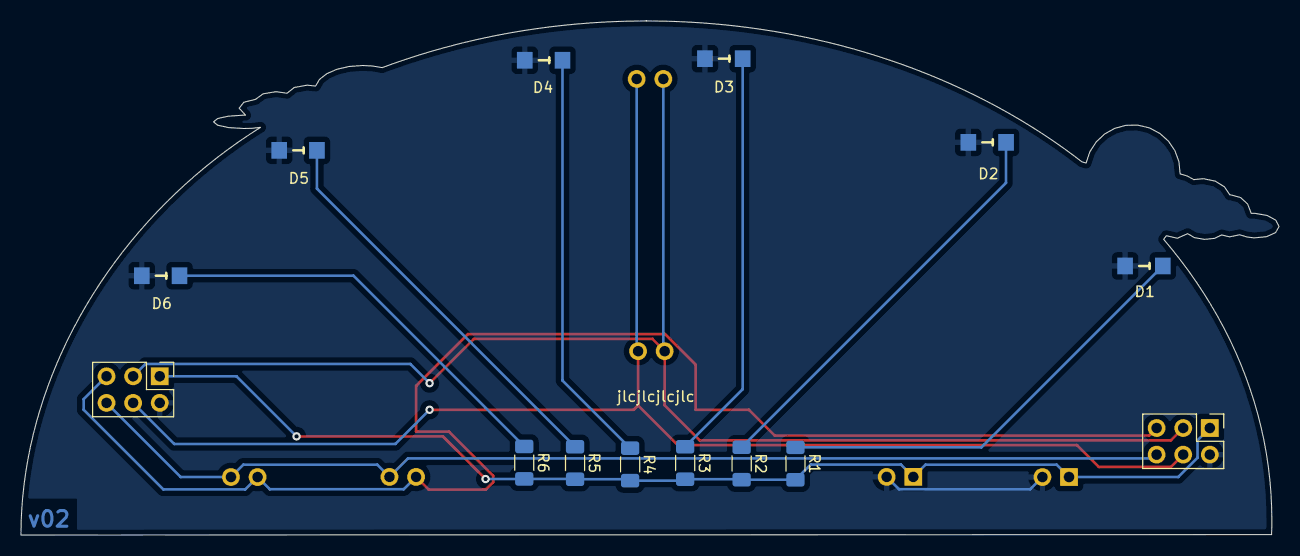
[picture p50: board sky_base.kicad_pcb from below]

Board: 2 copper layers, 120.1 x 49.1 mm, 17 parts (14 on the bottom side), 12 nets.

Other parts of the board:
svg2mod: G***; sky_base
