AerospaceVillage/avBadge_2022/(commit log)

2022-04-05 Initial badge prototyping
    [Bom_sr71.csv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]
2022-04-26 Working on the main village base badge
    [BaseBadge-B_Cu.gbl, BaseBadge-B_Mask.gbs, BaseBadge-B_Paste.gbp, BaseBadge-B_Silkscreen.gbo, BaseBadge-Edge_Cuts.gm1, BaseBadge-F_Cu.gtl, BaseBadge-F_Mask.gts, BaseBadge-F_Paste.gtp]
2022-05-04 v0.1 of the gold star SAO
    [gold_star-B_Cu.gbl, gold_star-B_Mask.gbs, gold_star-B_Paste.gbp, gold_star-B_Silkscreen.gbo, gold_star-F_Cu.gtl, gold_star-F_Mask.gts, gold_star-F_Paste.gtp, gold_star-F_Silkscreen.gto]
2022-05-04 First pass at james webb telescope SAO
    [jwtelescope.kicad_pcb, jwtelescope.kicad_sch]
2022-05-06 updated remove before flight to v02
    [Remove_Before_Flight-B_Cu.gbr, Remove_Before_Flight-B_Mask.gbr, Remove_Before_Flight-B_Paste.gbr, Remove_Before_Flight-B_Silkscreen.gbr, Remove_Before_Flight-Edge_Cuts.gbr, Remove_Before_Flight-F_Cu.gbr, Remove_Before_Flight-F_Mask.gbr, Remove_Before_Flight-F_Paste.gbr]
2022-05-11 overhauls across boards to v02
    [BaseBadge-BOM.csv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]
2022-05-11 removing unnecassary backups
    [Master_Warning-B_Cu.gbl, Master_Warning-B_Mask.gbs, Master_Warning-B_Paste.gbp, Master_Warning-B_SilkS.gbo, Master_Warning-Edge_Cuts.gm1, Master_Warning-F_Cu.gtl, Master_Warning-F_Mask.gts, Master_Warning-F_Paste.gtp]
2022-05-12 updated earth portion for fabrication
    [earth_base-B_Cu.gbl, earth_base-B_Mask.gbs, earth_base-B_Paste.gbp, earth_base-B_Silkscreen.gbo, earth_base-Edge_Cuts.gm1, earth_base-F_Cu.gtl, earth_base-F_Mask.gts, earth_base-F_Paste.gtp]
2022-05-22 updated per latest protoype discoveries
    [Master_Warning-B_Cu.gbl, Master_Warning-B_Mask.gbs, Master_Warning-B_Paste.gbp, Master_Warning-B_SilkS.gbo, Master_Warning-B_Silkscreen.gbo, Master_Warning-Edge_Cuts.gm1, Master_Warning-F_Cu.gtl, Master_Warning-F_Mask.gts]
2022-05-22 added gold_star_v2 and some other small updates
    [av_logo.kicad_pcb, av_logo.kicad_sch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]
2022-05-23 Small update to basic gold star
    [gold_star-B_Cu.gbl, gold_star-B_Mask.gbs, gold_star-B_Paste.gbp, gold_star-B_Silkscreen.gbo, gold_star-Edge_Cuts.gm1, gold_star-F_Cu.gtl, gold_star-F_Mask.gts, gold_star-F_Paste.gtp]
2022-05-23 v0.1 of the gold star with copper showing
    [gold_star_v2_SAO-B_Cu.gbl, gold_star_v2_SAO-B_Mask.gbs, gold_star_v2_SAO-B_Paste.gbp, gold_star_v2_SAO-B_Silkscreen.gbo, gold_star_v2_SAO-Edge_Cuts.gm1, gold_star_v2_SAO-F_Cu.gtl, gold_star_v2_SAO-F_Mask.gts, gold_star_v2_SAO-F_Paste.gtp]
2022-05-26 added artwork to back of base badge
    [BaseBadge.kicad_pcb, BaseBadge.kicad_sch]
2022-05-26 updated base badge, shuttle, and warning
    [BaseBadge-BOM.csv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]
2022-06-02 added Registered trademark thing
    [BaseBadge.kicad_pcb]
2022-06-02 v04 of base badge and arduino addition.
    [BaseBadge-B_Cu.gbl, BaseBadge-B_Mask.gbs, BaseBadge-B_Paste.gbp, BaseBadge-B_Silkscreen.gbo, BaseBadge-Edge_Cuts.gm1, BaseBadge-F_Cu.gtl, BaseBadge-F_Mask.gts, BaseBadge-F_Paste.gtp]
2022-06-18 v1 of JWT SAO
    Just the badge without electronics to see how the manufacturing goes.
    [jwtelescope.kicad_pcb]
2022-06-18 Removed gerber folder from the gold star SAO folder that wasn't needed
    [gold_star-B_Cu.gbl, gold_star-B_Mask.gbs, gold_star-B_Paste.gbp, gold_star-B_Silkscreen.gbo, gold_star-F_Cu.gtl, gold_star-F_Mask.gts, gold_star-F_Paste.gtp, gold_star-F_Silkscreen.gto]
2022-06-18 Removed more unnecessary folders from the gold star SAO folders
    [gold_star_v2_SAO-B_Cu.gbl, gold_star_v2_SAO-B_Mask.gbs, gold_star_v2_SAO-B_Paste.gbp, gold_star_v2_SAO-B_Silkscreen.gbo, gold_star_v2_SAO-F_Cu.gtl, gold_star_v2_SAO-F_Mask.gts, gold_star_v2_SAO-F_Paste.gtp, gold_star_v2_SAO-F_Silkscreen.gto]
2022-06-18 v01 of jwtelescope gerbers
    [jwtelescope-B_Cu.gbl, jwtelescope-B_Mask.gbs, jwtelescope-B_Paste.gbp, jwtelescope-B_Silkscreen.gbo, jwtelescope-Edge_Cuts.gm1, jwtelescope-F_Cu.gtl, jwtelescope-F_Mask.gts, jwtelescope-F_Paste.gtp]
2022-06-19 Initial commit of crew SAO extender
    [crew-SAO-extender-B_Cu.gbl, crew-SAO-extender-B_Mask.gbs, crew-SAO-extender-B_Paste.gbp, crew-SAO-extender-B_Silkscreen.gbo, crew-SAO-extender-Edge_Cuts.gm1, crew-SAO-extender-F_Cu.gtl, crew-SAO-extender-F_Mask.gts, crew-SAO-extender-F_Paste.gtp]
2022-06-27 added some images/files to the crew and speaker SAOs
    [speaker-SAO-B_Cu.gbl, speaker-SAO-B_Mask.gbs, speaker-SAO-B_Paste.gbp, speaker-SAO-B_Silkscreen.gbo, speaker-SAO-Edge_Cuts.gm1, speaker-SAO-F_Cu.gtl, speaker-SAO-F_Mask.gts, speaker-SAO-F_Paste.gtp]
2022-06-27 assembly instructions for base badge, shuttle SAO, and warning SAO
2022-07-16 first attempt at a v2 of the JWT that includes LEDs
    [jwtelescope.kicad_pcb, jwtelescope.kicad_sch]
2022-07-16 adjustement to sr-71
    [sr-71-B_Cu.gbl, sr-71-B_Mask.gbs, sr-71-B_Paste.gbp, sr-71-B_SilkS.gbo, sr-71-B_Silkscreen.gbo, sr-71-Edge_Cuts.gm1, sr-71-F_Cu.gtl, sr-71-F_Mask.gts]
2022-07-17 upgrade sr-71 to latest kicad 6 version
    [sr-71.kicad_sch]
2022-07-19 JWT SAO v2 gerbers generated
    [jwtelescope-B_Cu.gbl, jwtelescope-B_Mask.gbs, jwtelescope-B_Paste.gbp, jwtelescope-B_Silkscreen.gbo, jwtelescope-Edge_Cuts.gm1, jwtelescope-F_Cu.gtl, jwtelescope-F_Mask.gts, jwtelescope-F_Paste.gtp]
2022-07-21 added 787 SAO extender with Boeing logo
    [787-B_Cu.gbl, 787-B_Mask.gbs, 787-B_Paste.gbp, 787-B_Silkscreen.gbo, 787-Edge_Cuts.gm1, 787-F_Cu.gtl, 787-F_Mask.gts, 787-F_Paste.gtp]
2022-07-21 JWT SAO v3 - removed copper fill and there was a trace that didn't connect properly
    [jwtelescope-B_Cu.gbr, jwtelescope-B_Mask.gbr, jwtelescope-B_Paste.gbr, jwtelescope-B_Silkscreen.gbr, jwtelescope-Edge_Cuts.gbr, jwtelescope-F_Cu.gbr, jwtelescope-F_Mask.gbr, jwtelescope-F_Paste.gbr]
2022-07-21 Still kept v3, but increased the trace width to .254mm
    [jwtelescope-B_Cu.gbr, jwtelescope-B_Mask.gbr, jwtelescope-B_Paste.gbr, jwtelescope-B_Silkscreen.gbr, jwtelescope-Edge_Cuts.gbr, jwtelescope-F_Cu.gbr, jwtelescope-F_Mask.gbr, jwtelescope-F_Paste.gbr]
2022-07-21 added schematic to 787 SAO extender
    [787.kicad_sch]
2022-07-21 787 footprints and netlist
    [787.kicad_sch]
2022-07-21 cleaned out the old gerber files for the 787 extender
    [787-B_Cu.gbl, 787-B_Mask.gbs, 787-B_Paste.gbp, 787-B_Silkscreen.gbo, 787-Edge_Cuts.gm1, 787-F_Cu.gtl, 787-F_Mask.gts, 787-F_Paste.gtp]
2022-07-21 Updated 787 SAO extender to have solder mask areas for the cockpit windows along with a rough outline of a keepout area.
    [787.kicad_pcb]
2022-07-22 Updates to 787 SAO extender
    [787-B_Cu.gbr, 787-B_Mask.gbr, 787-B_Paste.gbr, 787-B_Silkscreen.gbr, 787-Edge_Cuts.gbr, 787-F_Cu.gbr, 787-F_Mask.gbr, 787-F_Paste.gbr]
2022-07-22 v2 of crew SAO. Built the runway mostly within KiCAD.
    [crew-SAO-B_Cu.gbr, crew-SAO-B_Mask.gbr, crew-SAO-B_Paste.gbr, crew-SAO-B_Silkscreen.gbr, crew-SAO-Edge_Cuts.gbr, crew-SAO-F_Cu.gbr, crew-SAO-F_Mask.gbr, crew-SAO-F_Paste.gbr]
2022-07-22 v2 of speaker SAO. Built the runway mostly within KiCAD.
    [speaker-SAO-B_Cu.gbl, speaker-SAO-B_Cu.gbr, speaker-SAO-B_Mask.gbr, speaker-SAO-B_Mask.gbs, speaker-SAO-B_Paste.gbp, speaker-SAO-B_Paste.gbr, speaker-SAO-B_Silkscreen.gbo, speaker-SAO-B_Silkscreen.gbr]
2022-07-22 Updates to JWT SAO. Still considering it v3.
    [jwtelescope-B_Cu.gbr, jwtelescope-B_Mask.gbr, jwtelescope-B_Paste.gbr, jwtelescope-B_Silkscreen.gbr, jwtelescope-Edge_Cuts.gbr, jwtelescope-F_Cu.gbr, jwtelescope-F_Mask.gbr, jwtelescope-F_Paste.gbr]
2022-07-22 Manually incorporated thicker lines on shield from Dan's branch
    [jwtelescope-B_Cu.gbr, jwtelescope-B_Mask.gbr, jwtelescope-B_Paste.gbr, jwtelescope-B_Silkscreen.gbr, jwtelescope-Edge_Cuts.gbr, jwtelescope-F_Cu.gbr, jwtelescope-F_Mask.gbr, jwtelescope-F_Paste.gbr]
2022-07-25 added B2 SAO
    [B2-B_Cu.gbr, B2-B_Mask.gbr, B2-B_Paste.gbr, B2-B_Silkscreen.gbr, B2-Edge_Cuts.gbr, B2-F_Cu.gbr, B2-F_Mask.gbr, B2-F_Paste.gbr]
2022-07-25 b2 with schematic and green led
    [B2.kicad_pcb, B2.kicad_sch]
2022-07-25 b2 with v03 gerbers
    [B2-B_Cu.gbl, B2-B_Cu.gbr, B2-B_Mask.gbs, B2-B_Paste.gbp, B2-B_Paste.gbr, B2-B_Silkscreen.gbo, B2-Edge_Cuts.gm1, B2-F_Cu.gtl]
2022-07-25 v4 of B2 SAO. Added front copper layer. Used a cleaner outline that shifted some things slightly.
    [B2.kicad_pcb]
2022-07-26 B2 SAO gerber outputs for v4
    [B2-B_Cu.gbl, B2-B_Mask.gbs, B2-B_Paste.gbp, B2-B_Silkscreen.gbo, B2-Edge_Cuts.gm1, B2-F_Cu.gtl, B2-F_Mask.gts, B2-F_Paste.gtp]
2022-07-29 Adding VORTAC SAO
    Adding VORTAC 3-way SAO
    [VORTAC SAO Board.kicad_pcb, VORTAC SAO Board.kicad_sch]
2022-07-29 added SAO soldering jig to the repo
    [sao_jig-single.3mf, sao_jig-x15.3mf, sao_jig.stl]
2022-07-29 added text and credit
    [VORTAC SAO Board.kicad_pcb]
2022-07-29 added AN225 SAO
    [an225-B_Cu.gbr, an225-B_Mask.gbr, an225-B_Paste.gbr, an225-B_Silkscreen.gbr, an225-Edge_Cuts.gbr, an225-F_Cu.gbr, an225-F_Mask.gbr, an225-F_Paste.gbr]
2022-07-29 added gerber outputs to vortac SAO
    [VORTAC SAO Board-B_Cu.gbr, VORTAC SAO Board-B_Mask.gbr, VORTAC SAO Board-B_Paste.gbr, VORTAC SAO Board-B_Silkscreen.gbr, VORTAC SAO Board-Edge_Cuts.gbr, VORTAC SAO Board-F_Cu.gbr, VORTAC SAO Board-F_Mask.gbr, VORTAC SAO Board-F_Paste.gbr]
2022-07-29 added jlcjlcjlcjlc to the back of the vortac SAO
    [VORTAC SAO Board-B_Cu.gbr, VORTAC SAO Board-B_Mask.gbr, VORTAC SAO Board-B_Paste.gbr, VORTAC SAO Board-B_Silkscreen.gbr, VORTAC SAO Board-Edge_Cuts.gbr, VORTAC SAO Board-F_Cu.gbr, VORTAC SAO Board-F_Mask.gbr, VORTAC SAO Board-F_Paste.gbr]
2022-07-29 Duplicated the 787 SAO multiplier to have a version without the Boeing logo since we had actually received logo approval with the placement. This version replaces the Boeing logo with the AV logo.
    [787-B_Cu.gbr, 787-B_Mask.gbr, 787-B_Paste.gbr, 787-B_Silkscreen.gbr, 787-Edge_Cuts.gbr, 787-F_Cu.gbr, 787-F_Mask.gbr, 787-F_Paste.gbr]
2022-07-30 speaker and crew SAOs updated to v3 that moves the connector slightly so it doesn't stick out
    [crew-SAO-B_Cu.gbr, crew-SAO-B_Mask.gbr, crew-SAO-B_Paste.gbr, crew-SAO-B_Silkscreen.gbr, crew-SAO-Edge_Cuts.gbr, crew-SAO-F_Cu.gbr, crew-SAO-F_Mask.gbr, crew-SAO-F_Paste.gbr]
2022-08-01 v3 of AN225. Had an error caught by the manufacturer where the silkscreen was covering the holes because I exported without the silkscreen removal checkbox checked (on purpose)
    [an225-B_Cu.gbr, an225-B_Mask.gbr, an225-B_Paste.gbr, an225-B_Silkscreen.gbr, an225-Edge_Cuts.gbr, an225-F_Cu.gbr, an225-F_Mask.gbr, an225-F_Paste.gbr]
2022-08-01 spread out the components on the JWT SAO so they aren't so close to the connector
    [jwtelescope.kicad_pcb]
2022-08-02 JWT SAO v4 with thicker lines for the shields
    [jwtelescope-B_Cu.gbr, jwtelescope-B_Mask.gbr, jwtelescope-B_Paste.gbr, jwtelescope-B_Silkscreen.gbr, jwtelescope-Edge_Cuts.gbr, jwtelescope-F_Cu.gbr, jwtelescope-F_Mask.gbr, jwtelescope-F_Paste.gbr]
